kartikye/MySat/README.md

# SASSat
Singapore American School Satellite
