kartikye/MySat/Schematics/EPS/Flight Model/Charging Rate.xlsx

Time | Voltage
12:47:00 | 3.837
12:52:00 | 3.843
12:58:00 | 3.851
13:03:00 | 3.856
13:08:00 | 3.861
13:13:00 | 3.864
13:18:00 | 3.87
13:24:00 | 3.875
13:29:00 | 3.881
13:43:00 | 3.883
13:59:00 | 3.888
14:27:00 | 3.89
14:44:00 | 3.918
14:52:00 | 3.929
15:03:00 | 3.943
15:33:00 | 3.958
