kartikye/MySat/Costs.xlsx

Sheet: Overview
Simple Space Systems BOM
No. | Subsystem | Number of Parts | Cost
1 | Electronic Power System | 114 | $117.62
2 | Radio Board | 11 | $49.75
3 | On Board Computer | 25 | $52.65
4 | Structure | 55 | $435.14
5 | Labsat | 35 | $89.52
 |  | Total | $744.67
 |  | Sell Price | $4000.00
 |  | Profit | $3255.33
 |  | Markup | 437.1474898%

Sheet: LabSat
Structure BOM
No. | Type | Part | Value | Quantity | Manufacturer | Cost | Total
1 | Connector | FX8C-60P-SV |  | 4 | Hirose | $5.76 | $23.03
2 | Switch | TL3301 |  | 1 | E-Switch | $0.67 | $0.67
3 | Programmer | Arduino Uno |  | 1 | Arduino | $33.92 | $33.92
4 | Standoff | 2mm Standoff |  | 28 |  |  | $0.00
5 |  |  |  |  |  |  | $0.00
6 |  |  |  |  |  |  | $0.00
 | PCB |  |  | 1 | SeeedStudio | $31.90 | $31.90
 |  |  |  |  |  |  | $0.00
 |  |  |  |  |  |  | $0.00
 |  |  |  |  |  |  | $0.00
 |  |  |  |  |  |  | $0.00
 |  |  |  |  |  |  | $0.00
 |  |  |  |  |  |  | $0.00
 | Total: |  |  |  |  |  | $89.52

Sheet: Structure
Structure BOM
No. | Type | Part | Value | Quantity | Manufacturer | Cost | Total
1 | PCB | Side Panel |  | 4 | SeeedStudio | $2.71 | $10.84
2 | PCB | Top Panel |  | 1 | SeeedStudio | $2.71 | $2.71
3 | PCB | Bottom Panel |  | 1 | SeeedStudio | $4.10 | $4.10
4 | Solar Cells | Solar Cell |  | 48 | TriSolX | $5.43 | $260.64
5 | CNC | Corners |  | 1 | SeeedStudio | $146.43 | $146.43
6 | Switches | D2MQ-1L |  | 2 | Omron | $5.21 | $10.42
 | Total: |  |  |  |  |  | $435.14

Sheet: On Board Computer
On Board Computer BOM |  |  |  |  |  |  |  | Octopart Add-In is ready | j
No. | Type | Part | Value | Quantity | Manufacturer | Cost | Total |  | Datasheet
1 | Capacitor | 0805B104J500CT | 0.1uF | 4 |  | $0.004 | $0.02 |  | http://datasheet.octopart.com/0805B104J500CT-Walsin-Technologies-datasheet-48038160.pdf
2 | Capacitor | C0805C224K5RACTU | 0.22uF | 1 |  | $0.07 | $0.07 |  | http://datasheet.octopart.com/C0805C224K5RAC7800-Kemet-datasheet-62098571.pdf
3 | Capacitor | C0805C475K3PACTU | 4.7uF | 1 |  | $0.47 | $0.47 |  | http://datasheet.octopart.com/C0805C475K3PACTU-Kemet-datasheet-60243838.pdf
4 | Capacitor | 0805N220J500CT | 22pF | 2 |  | $0.03 | $0.06 |  | http://datasheet.octopart.com/0805N220J500CT-Walsin-Technologies-datasheet-48038160.pdf
5 | Tantalum Capacitor | TAJR106K006RNJ | 10uF | 1 |  | $0.44 | $0.44 |  | http://datasheet.octopart.com/TAJR106K006RNJ-AVX-datasheet-10925046.pdf
6 | Connector | FX8C-60S-SV |  | 1 | Hirose | $6.35 | $6.35 |  | http://datasheet.octopart.com/FX8C-60S-SV5%2891%29-Hirose-datasheet-8384353.pdf
7 | Connector | FX8C-60P-SV |  | 1 | Hirose | $5.76 | $5.76 |  | http://datasheet.octopart.com/FX8C-60P-SV6%2891%29-Hirose-datasheet-44103168.pdf
8 | Connector | SHR-02V-S-B |  | 1 |  | $0.02 | $0.02 |  | http://datasheet.octopart.com/SHR-02V-S-B-JST-datasheet-5322443.pdf
9 | Resistor | CR0805-JW-104ELF | 10k | 5 |  | $0.16 | $0.82 |  | http://datasheet.octopart.com/CR0805-JW-104ELF-Bourns-datasheet-49799764.pdf
10 | IC | ATMEGA328P-AU |  | 1 | Atmel | $5.73 | $5.73 |  | http://datasheet.octopart.com/ATMEGA328P-AU-Atmel-datasheet-14421303.pdf
11 | IC | DS1388Z-33+T&R |  | 1 |  | $4.95 | $4.95 |  | http://datasheet.octopart.com/DS1388Z-33%2BT%26R-Maxim-Integrated-datasheet-62054837.pdf
12 | IC | LSM9DS0 |  | 1 | ST Electronics | $14.99 | $14.99 |  | http://datasheet.octopart.com/LSM9DS0TR-STMicroelectronics-datasheet-16347594.pdf
13 | IC | LTC2990IMSPBF |  | 1 | Linear Technologies | $9.00 | $9.00 |  | http://datasheet.octopart.com/LTC2990IMS%23PBF-Linear-Technology-datasheet-10978018.pdf
14 | Inductor | CI160808-4N7D |  | 1 |  | $0.16 | $0.16 |  | http://datasheet.octopart.com/CI160808-4N7D-Bourns-datasheet-11480061.pdf
15 | Crystal | ABS25-32.768KHZ-6-T |  | 1 |  | $0.70 | $0.70 |  | http://datasheet.octopart.com/ABS25-32.768KHZ-6-T-Abracon-datasheet-11036012.pdf
16 | Crystal | ABM3-16.000MHZ-B2-T |  | 1 |  | $1.11 | $1.11 |  | http://datasheet.octopart.com/ABM3-16.000MHZ-B2-T-Abracon-datasheet-8488864.pdf
17 | PCB | PCB |  | 1 | SeeedStudio | $2.00 | $2.00
18 | Connector | 2998 |  | 1 | Keystone | ERROR: Server did not provide a response (The operation has timed out)
 | Total: |  |  |  |  |  | $52.65

Sheet: Electronic Power System
Electronic Power System BOM |  |  |  |  |  |  |  | Octopart Add-In is ready | h
No. | Type | Part | Value | Quantity | Manufacturer | Cost | Total |  |  | Datasheet
1 | Inductor | ELL6SH100M | 10uH | 3 | Panasonic | $1.83 | $5.49 |  |  | http://datasheet.octopart.com/ELL-6SH100M-Panasonic-datasheet-5327908.pdf
2 | Inductor | ELL3FU2R2N | 2.2uH | 1 | Panasonic | $2.10 | $2.10 |  |  | http://datasheet.octopart.com/ELL3FU2R2N-Panasonic-datasheet-10121769.pdf
3 | Capacitor | 0805B104J500CT | 0.1uF | 16 | Walsin Technologies | $0.04 | $0.69 |  |  | http://datasheet.octopart.com/0805B104J500CT-Walsin-Technologies-datasheet-48038160.pdf
4 | Capacitor | C2012X7R1E105K125AB | 1uF | 3 | Walsin Technologies | $0.23 | $0.68 |  |  | http://datasheet.octopart.com/C2012X7R1E105K-TDK-datasheet-10978788.pdf
5 | Capacitor | C0805C475K3PACTU | 4.7uF | 8 | Walsin Technologies | $0.47 | $3.75 |  |  | http://datasheet.octopart.com/C0805C475K3PACTU-Kemet-datasheet-60243838.pdf
6 | Capacitor | 0805F106Z100CT | 10uF | 8 | Walsin Technologies | $0.12 | $0.93 |  |  | http://datasheet.octopart.com/0805F106Z100CT-Walsin-Technologies-datasheet-48038160.pdf
7 | Resistor | ERJP06F7870V | 787 | 1 | Panasonic | $0.12 | $0.12 |  |  | http://datasheet.octopart.com/ERJ-P06F7870V-Panasonic-datasheet-13272697.pdf
8 | Resistor | CR0805-FX-4701ELF | 4.7k | 3 | Bourns | $0.16 | $0.49 |  |  | http://datasheet.octopart.com/CR0805-FX-4701ELF-Bourns-datasheet-49799764.pdf
9 | Resistor | CR0805-FX-1502ELF | 15k | 3 | Bourns | $0.16 | $0.49 |  |  | http://datasheet.octopart.com/CR0805-FX-1502ELF-Bourns-datasheet-49799764.pdf
10 | Resistor | ERJP06F2152V | 21.5k | 1 | Panasonic | $0.12 | $0.12 |  |  | http://datasheet.octopart.com/ERJP06F2152V-Panasonic-datasheet-5389633.pdf
11 | Resistor | ERJP06F3572V | 35.7k | 8 | Panasonic | $0.12 | $0.96 |  |  | http://datasheet.octopart.com/ERJ-P06F3572V-Panasonic-datasheet-13272697.pdf
12 | Resistor | CR0805-JW-104ELF | 100k | 8 | Bourns | $0.16 | $1.30 |  |  | http://datasheet.octopart.com/CR0805-JW-104ELF-Bourns-datasheet-49799764.pdf
13 | Resistor | ERJU06F4703V | 466k | 3 |  | $0.11 | $0.33 |  |  | http://datasheet.octopart.com/ERJU06F4703V-Panasonic-datasheet-11808117.pdf
14 | Resistor | ERJU06F4703V | 470k | 5 |  | $0.11 | $0.55 |  |  | http://datasheet.octopart.com/ERJU06F4703V-Panasonic-datasheet-11808117.pdf
15 | IC | BQ24210DQCT |  | 1 | Texas Instruments | $4.21 | $4.21 |  |  | https://octopart-clicks.com/click/track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
16 | IC | TPS2552DRVT |  | 6 | Texas Instruments | $2.86 | $17.18 |  |  | https://octopart-clicks.com/click/track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
17 | IC | TPS2553DRVT |  | 2 | Texas Instruments | $3.63 | $7.26 |  |  | https://octopart-clicks.com/click/track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
18 | Connector | FX8C-60P-SV |  | 1 | Hirose | $5.76 | $5.76 |  |  | http://datasheet.octopart.com/FX8C-60P-SV6%2891%29-Hirose-datasheet-44103168.pdf
19 | Connector | FX8C-60S-SV |  | 1 | Hirose | $6.35 | $6.35 |  |  | http://datasheet.octopart.com/FX8C-60S-SV5%2891%29-Hirose-datasheet-8384353.pdf
20 | Connector | SHR-02V-S-B |  | 10 |  | $0.19 | $1.87 |  |  | http://datasheet.octopart.com/SHR-02V-S-B-JST-datasheet-5322443.pdf
21 | Connector | SHR-03V-S-B |  | 10 |  | $0.08 | $0.85 |  |  | http://datasheet.octopart.com/SHR-03V-S-B-JST-datasheet-12489618.pdf
22 | IC | LTC3105EDDPBF |  | 3 | Linear Technologies | $9.41 | $28.23 |  |  | http://datasheet.octopart.com/LTC3105EDD%23PBF-Linear-Technology-datasheet-10546524.pdf
23 | IC | LTC4413EDDPBF |  | 5 | Linear Technologies | $3.85 | $19.25 |  |  | http://datasheet.octopart.com/LTC4413EDD%23PBF-Linear-Technology-datasheet-10701953.pdf
24 | IC | MCP130T-315I/TT |  | 1 |  | $0.36 | $0.36 |  |  | http://datasheet.octopart.com/MCP130T-315I/TT-Microchip-datasheet-345.pdf
25 | IC | PCA9534PW |  | 1 | Texas Instruments | $3.16 | $3.16 |  |  | https://octopart-clicks.com/click/track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
26 | IC | TPS63001DRCR |  | 1 | Texas Instruments | $3.13 | $3.13 |  |  | https://octopart-clicks.com/click/track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
27 | PCB | PCB |  | 1 | SeeedStudio | $2.00 | $2.00
 | Total: |  |  |  |  |  | $117.62

Sheet: Radio Board
Radio Board BOM |  |  |  |  |  |  |  | Octopart Add-In is ready | k
No. | Type | Part | Value | Quantity | Manufacturer | Cost | Total |  | Datasheet
1 | Polarized Capacitor | F980J476MSA | 47uF | 1 |  | $0.38 | $0.38 |  | ERROR: Datasheet url not found. Please try expanding your search
2 | Capacitor | 0805B104J500CT | 0.1uF | 1 |  | $0.004 | $0.004 |  | http://datasheet.octopart.com/0805B104J500CT-Walsin-Technologies-datasheet-48038160.pdf
3 | Balun | CX2156NL |  | 1 | Pulse | $2.73 | $2.73 |  | http://datasheet.octopart.com/CX2156NL-Pulse-datasheet-8613745.pdf
4 | IC | RF4463F30 |  | 2 | NiceRf | $11.86 | $23.72
5 | Connector | FX8C-60S-SV |  | 1 | Hirose | $6.35 | $6.35 |  | http://datasheet.octopart.com/FX8C-60S-SV5%2891%29-Hirose-datasheet-8384353.pdf
6 | Connector | FX8C-60P-SV |  | 1 | Hirose | $5.76 | $5.76 |  | http://datasheet.octopart.com/FX8C-60P-SV6%2891%29-Hirose-datasheet-44103168.pdf
7 | Connector | A-2JA |  | 2 | Amphenol RF | $1.31 | $2.62 |  | http://datasheet.octopart.com/A-2JA-Amphenol-RF-datasheet-38162442.pdf
8 | Wire | A-2PA-081-050B2 |  | 1 | Amphenol RF | $6.18 | $6.18 |  | http://datasheet.octopart.com/A-2PA-081-050B2-Amphenol-RF-datasheet-38084996.pdf
9 | PCB | PCB |  | 1 | SeeedStudio | $2.00 | $2.00
 | Total: |  |  |  |  |  | $49.75

Sheet: Stock
Parts Stock
No. | Type | Part | Value | Manufacturer | Stock | Source | Cost
1 | Balun | CX2156NL |  | Pulse | 2 | Link | $2.73 | $5.46
2 | Capacitor | 0805N220J500CT | 22pF | Walsin | 30 | Link | $0.04 | $1.32
3 | Capacitor | 0805B104J500CT | 0.1uF | Walsin | 46 | Link | $0.04 | $1.98
4 | Capacitor | C0805C224K5RACTU | 0.22uF | Kemmet | 5 | Link | $0.07 | $0.37
5 | Capacitor | C2012X7R1E105K125AB | 1uF | Kemmet | 115 | Link | $0.16 | $18.52
6 | Capacitor | C0805C475K3PACTU | 4.7uF | Kemmet | 45 | Link | $0.22 | $10.04
7 | Capacitor | 0805F106Z100CT | 10uF | Walsin | 66 | Link | $0.12 | $7.66
8 | Connector | FX8C-60S-SV |  | Hirose | 3 | Link | $5.52 | $16.57
9 | Connector | FX8C-60P-SV |  | Hirose | 3 | Link | $4.89 | $14.66
10 | Connector | SHR-02V-S-B |  | JST | 0 | Link | $0.19 | $0.00
11 | Connector | SHR-03V-S-B |  | JST | 0 | Link | $0.08 | $0.00
12 | Connector | A-2JA |  | Amphenol RF | 5 | Link | $1.31 | $6.55
13 | Crystal | ABS25-32.768KHZ-6-T |  | Abracon | 5 | Link | $0.58 | $2.89
14 | Crystal | ABM3-16.000MHZ-B2-T |  | Abracon | 7 | Link | $0.98 | $6.89
15 | IC | ATMEGA328P-AU |  | Atmel | 2 | Link | $5.28 | $10.55
16 | IC | DS1388Z-33+T&R |  | Maxim Integrated | 3 | Link | $4.49 | $13.47
17 | IC | LSM9DS0 |  | ST Electronics | 1 | Link | $12.27 | $12.27
18 | IC | LTC2990IMSPBF |  | Linear Technologies | 2 | Link | $8.66 | $17.31
19 | IC | BQ24210DQCT |  | Texas Instruments | 1 | Link | $3.69 | $3.69
20 | IC | TPS2552DRVT |  | Texas Instruments | 8 | Link | $2.68 | $21.43
21 | IC | TPS2553DRVT |  | Texas Instruments | 0 | Link | $2.73 | $0.00
22 | IC | LTC3105EDDPBF |  | Linear Technologies | 3 | Link | $9.41 | $28.23
23 | IC | LTC4413EDDPBF |  | Linear Technologies | 10 | Link | $3.80 | $38.00
24 | IC | MCP130T-315I/TT |  | Microchip | 2 | Link | $0.52 | $1.04
25 | IC | PCA9534PW |  | Texas Instruments | 10 | Link | $2.33 | $23.35
26 | IC | TPS63001DRCR |  | Texas Instruments | 9 | Link | $3.13 | $28.17
27 | IC | RF4463F30 |  | NiceRf | 1 | Link | $11.83 | $11.83
28 | Inductor | CI160808-4N7D |  | Bourns | 5 | Link | $0.08 | $0.38
29 | Resistor | ERJP06F7870V | 787 | Panasonic | 45 | Link | $0.10 | $4.59
30 | Resistor | CR0805-FX-4701ELF | 4.7k | Bourns | 36 | Link | $0.06 | $2.20
31 | Resistor | CR0805-JW-104ELF | 10k | Bourns | 253 | Link | $0.09 | $23.02
32 | Resistor | CR0805-FX-1502ELF | 15k | Bourns | 36 | Link | $0.11 | $4.03
33 | Resistor | ERJP06F2152V | 21.5k | Panasonic | 80 | Link | $0.10 | $8.16
34 | Resistor | ERJP06F3572V | 35.7k | Panasonic | 36 | Link | $0.10 | $3.67
35 | Resistor | CR0805-JW-104ELF | 100k | Bourns | 100 | Link | $0.09 | $9.10
36 | Resistor | ERJU06F4703V | 466k | Panasonic |  | Link | $0.09 | $0.00
37 | Resistor | ERJU06F4703V | 470k | Panasonic |  | Link | $0.09 | $0.00
38 | Switch | TL3301 |  | E-Switch | 2 | Link | $0.65 | $1.31
39 | Switch | D2MQ-1L |  | Omron | 4 | Link | $5.06 | $20.23
40 | Tantalum Capacitor | TAJR106K006RNJ | 10uF | AVX | 10 | Link | $11.86 | $118.60
41 | Tantalum Capacitor | F980J476MSA | 47uF | AVX | 4 | Link | $0.38 | $1.52
42 | Wire | A-2PA-081-050B2 |  | Amphenol RF | 3 | Link | $6.18 | $18.54
43 | Connector | 2998 |  | Keystone | 5 | Link | $7.19
44 | Inductor | ELL6SH100M | 10uH | Panasonic | 1 | Link | $1.42 | $1.42
45 | Inductor | ELL3FU2R2N | 2.2uH | Panasonic | 0 | Link | $2.03 | $0.00
46 |  |  | 487 |  | 48 | Link | ERROR: Server did not provide a response (The operation has timed out)
47 |  |  |  |  |  | Link | ERROR: Query did not provide a result. Please widen your search criteria.
48 |  |  |  |  |  | Link | ERROR: Query did not provide a result. Please widen your search criteria.
49 |  |  |  |  |  | Link | ERROR: Query did not provide a result. Please widen your search criteria.
50 |  |  |  |  |  | Link | ERROR: Query did not provide a result. Please widen your search criteria.
51 |  |  |  |  |  | Link | ERROR: Query did not provide a result. Please widen your search criteria.
52 |  |  |  |  |  | Link | ERROR: Query did not provide a result. Please widen your search criteria.
53 |  |  |  |  |  | Link | ERROR: Query did not provide a result. Please widen your search criteria.
54 |  |  |  |  |  | Link | ERROR: Query did not provide a result. Please widen your search criteria.
55 |  |  |  |  |  | Link | ERROR: Query did not provide a result. Please widen your search criteria.
56 |  |  |  |  |  | Link | ERROR: Query did not provide a result. Please widen your search criteria.
57 |  |  |  |  |  | Link | ERROR: Query did not provide a result. Please widen your search criteria.
58 |  |  |  |  |  | Link | ERROR: Query did not provide a result. Please widen your search criteria.
59 |  |  |  |  |  | Link | ERROR: Query did not provide a result. Please widen your search criteria.
60 |  |  |  |  |  | Link | ERROR: Query did not provide a result. Please widen your search criteria.
61 |  |  |  |  |  | Link | ERROR: Query did not provide a result. Please widen your search criteria.
62 |  |  |  |  |  | Link | ERROR: Query did not provide a result. Please widen your search criteria.
63 |  |  |  |  |  | Link | ERROR: Query did not provide a result. Please widen your search criteria.
64 |  |  |  |  |  | Link | ERROR: Query did not provide a result. Please widen your search criteria.
65 |  |  |  |  |  | Link | ERROR: Query did not provide a result. Please widen your search criteria.
66 |  |  |  |  |  | Link | ERROR: Query did not provide a result. Please widen your search criteria.
67 |  |  |  |  |  | Link | ERROR: Query did not provide a result. Please widen your search criteria.
68 |  |  |  |  |  | Link | ERROR: Query did not provide a result. Please widen your search criteria.
69 |  |  |  |  |  | Link | ERROR: Query did not provide a result. Please widen your search criteria.
70 |  |  |  |  |  | Link | ERROR: Query did not provide a result. Please widen your search criteria.
71 |  |  |  |  |  | Link | ERROR: Query did not provide a result. Please widen your search criteria.
72 |  |  |  |  |  | Link | ERROR: Query did not provide a result. Please widen your search criteria.
73 |  |  |  |  |  | Link | ERROR: Query did not provide a result. Please widen your search criteria.
74 |  |  |  |  |  | Link | ERROR: Query did not provide a result. Please widen your search criteria.
75 |  |  |  |  |  | Link | ERROR: Query did not provide a result. Please widen your search criteria.
76 |  |  |  |  |  | Link | ERROR: Query did not provide a result. Please widen your search criteria.
77 |  |  |  |  |  | Link | ERROR: Query did not provide a result. Please widen your search criteria.
78 |  |  |  |  |  | Link | ERROR: Query did not provide a result. Please widen your search criteria.
79 |  |  |  |  |  | Link | ERROR: Query did not provide a result. Please widen your search criteria.
80 |  |  |  |  |  | Link | ERROR: Query did not provide a result. Please widen your search criteria.
81 |  |  |  |  |  | Link | ERROR: Query did not provide a result. Please widen your search criteria.
82 |  |  |  |  |  | Link | ERROR: Query did not provide a result. Please widen your search criteria.
83 |  |  |  |  |  | Link | ERROR: Query did not provide a result. Please widen your search criteria.
84 |  |  |  |  |  | Link | ERROR: Query did not provide a result. Please widen your search criteria.
85 |  |  |  |  |  | Link | ERROR: Query did not provide a result. Please widen your search criteria.
86 |  |  |  |  |  | Link | ERROR: Query did not provide a result. Please widen your search criteria.
87 |  |  |  |  |  | Link | ERROR: Query did not provide a result. Please widen your search criteria.
88 |  |  |  |  |  | Link | ERROR: Query did not provide a result. Please widen your search criteria.
89 |  |  |  |  |  | Link | ERROR: Query did not provide a result. Please widen your search criteria.
90 |  |  |  |  |  | Link | ERROR: Query did not provide a result. Please widen your search criteria.
91 |  |  |  |  |  | Link | ERROR: Query did not provide a result. Please widen your search criteria.
92 |  |  |  |  |  | Link | ERROR: Query did not provide a result. Please widen your search criteria.
93 |  |  |  |  |  | Link | ERROR: Query did not provide a result. Please widen your search criteria.
94 |  |  |  |  |  | Link | ERROR: Query did not provide a result. Please widen your search criteria.
95 |  |  |  |  |  | Link | ERROR: Query did not provide a result. Please widen your search criteria.
96 |  |  |  |  |  | Link | ERROR: Query did not provide a result. Please widen your search criteria.
 | Total: |  |  |  | $383.00 |  |  | $519.02
 |  |  |  |  |  |  |  | .
