kartikye/MySat/Schematics/EPS/Flight Model/PQ60 EPS FV4.csv

Part | Value | Device | Package | Description
C1 | 10uF | C-USC0805 | C0805 | CAPACITOR, American symbol
C2 | 10uF | C-USC0805 | C0805 | CAPACITOR, American symbol
C3 | 10uF | C-USC0805 | C0805 | CAPACITOR, American symbol
C4 | 10uF | C-USC0805 | C0805 | CAPACITOR, American symbol
C5 | 10uF | C-USC0805 | C0805 | CAPACITOR, American symbol
C6 | 10uF | C-USC0805 | C0805 | CAPACITOR, American symbol
C7 | 4.7uF | C-USC0805 | C0805 | CAPACITOR, American symbol
C8 | 4.7uF | C-USC0805 | C0805 | CAPACITOR, American symbol
C9 | 10uF | C-USC0805 | C0805 | CAPACITOR, American symbol
C10 | 10uF | C-USC0805 | C0805 | CAPACITOR, American symbol
C11 | 4.7uF | C-USC0805 | C0805 | CAPACITOR, American symbol
C12 | 4.7uF | C-USC0805 | C0805 | CAPACITOR, American symbol
C13 | 4.7uF | C-USC0805 | C0805 | CAPACITOR, American symbol
C14 | 1uF | C-USC0805 | C0805 | CAPACITOR, American symbol
C15 | 1uF | C-USC0805 | C0805 | CAPACITOR, American symbol
C16 | 1uF | C-USC0805 | C0805 | CAPACITOR, American symbol
C17 | 0.1uF | C-USC0805 | C0805 | CAPACITOR, American symbol
C18 | .1uF | C-USC0805 | C0805 | CAPACITOR, American symbol
C19 | 0.1uF | C-USC0805 | C0805 | CAPACITOR, American symbol
C20 | 0.1uF | C-USC0805 | C0805 | CAPACITOR, American symbol
C21 | 4.7uF | C-USC0805 | C0805 | CAPACITOR, American symbol
C22 | 4.7uF | C-USC0805 | C0805 | CAPACITOR, American symbol
C23 | .1uF | C-USC0805 | C0805 | CAPACITOR, American symbol
C24 | 0.1uF | C-USC0805 | C0805 | CAPACITOR, American symbol
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
U10 | PCA9534PW | PCA9534PW | SOP65P640X110-16N | IC, IO PORT, I2C/SMBUS 8BIT, 16TSSOP
U11 | DRV | DRV | DRV
U12 | DRV | DRV | DRV
U13 | LTC4413EDDPBF | LTC4413EDDPBF | DFN300X300X80-11N | Dual 2.6A, 2.5V to 5.5V, Ideal Diodes
U14 | DRV | DRV | DRV
U15 | DRV | DRV | DRV
U16 | LTC4413EDDPBF | LTC4413EDDPBF | DFN300X300X80-11N | Dual 2.6A, 2.5V to 5.5V, Ideal Diodes
U17 | DRV | DRV | DRV
U18 | DRV | DRV | DRV
U19 | LTC4413EDDPBF | LTC4413EDDPBF | DFN300X300X80-11N | Dual 2.6A, 2.5V to 5.5V, Ideal Diodes
