kartikye/MySat/Schematics/Solar Panel/Full Side Panel V4 - Notched.dxf

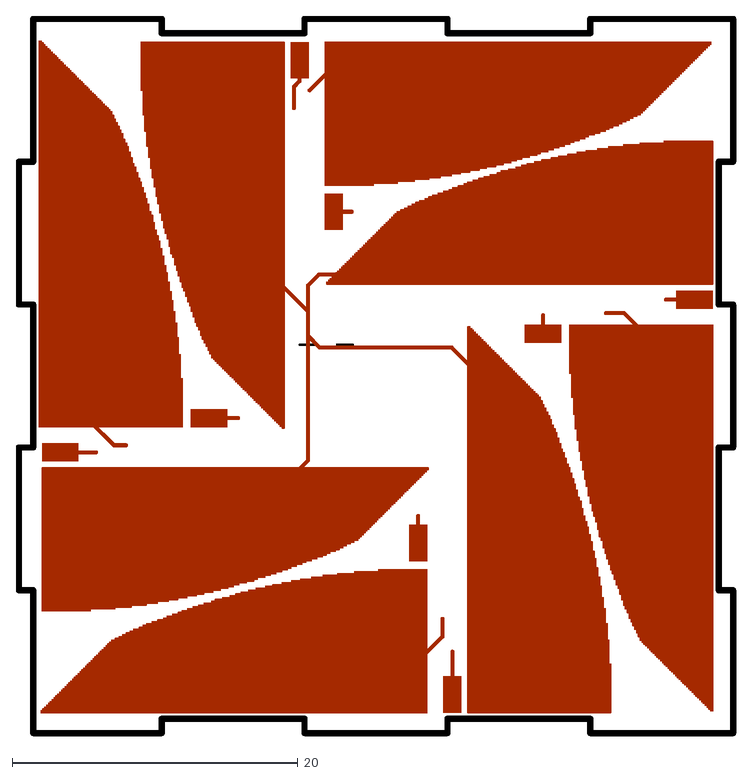
[picture p1: CAD file, 2015-08-25]
Schematics/Solar Panel/Full Side Panel V4 - Notched.dxf
50.4 x 50.4
