kartikye/MySat/Schematics/Solar Panel/All Panels V4 - Notched.dxf

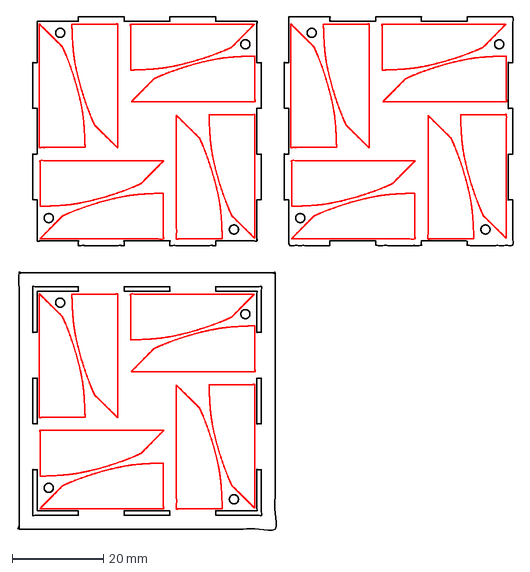
[picture p2: CAD file, 2015-08-25]
Schematics/Solar Panel/All Panels V4 - Notched.dxf
108.7 x 112.7 mm
