kartikye/MySat/Structure/EPS/Parts/FX8C-60P-SV.stp

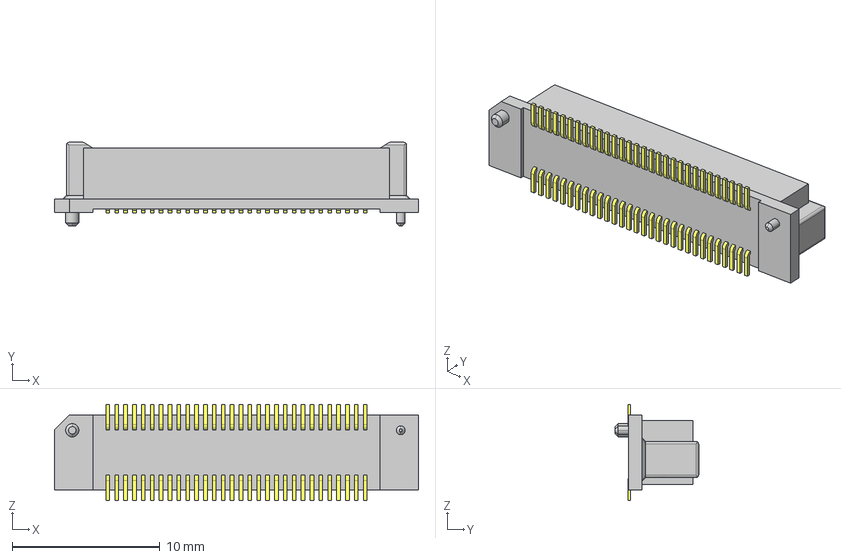
[picture p3: CAD file, 2015-12-20]
Structure/EPS/Parts/FX8C-60P-SV.stp
24.6 x 5.65 x 6.50 mm
