kartikye/MySat/Structure/V5/D2MQ_1.step

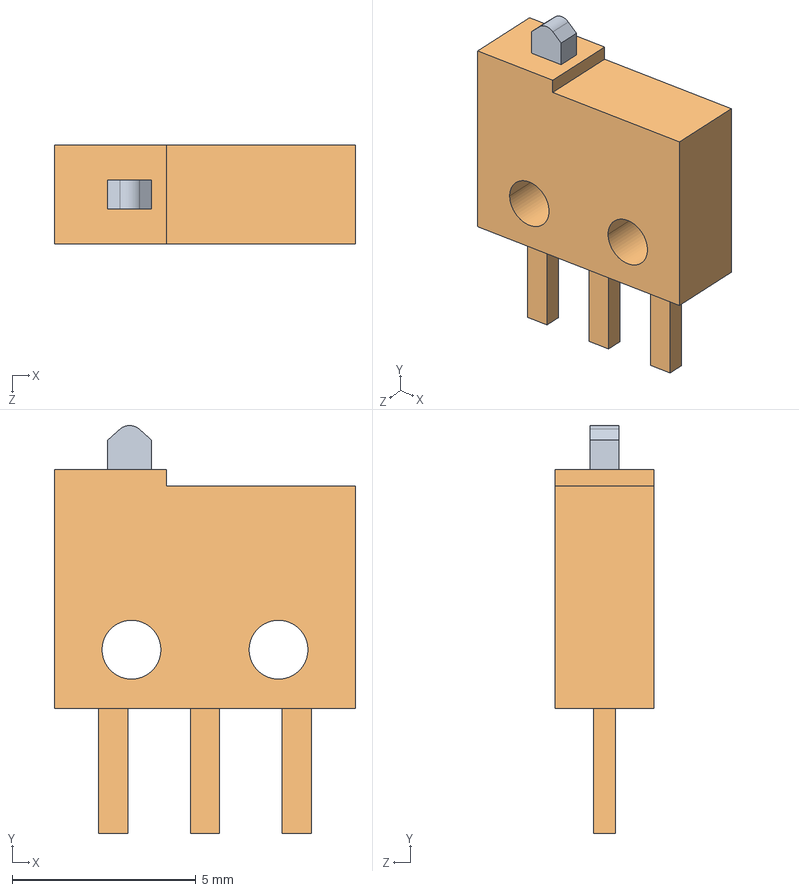
[picture p4: CAD file, 2015-12-20]
Structure/V5/D2MQ_1.step
8.20 x 11.1 x 2.70 mm
D2MQ_1_ACTUATOR
D2MQ_1_BASE
