kartikye/MySat/Schematics/Solar Panel/Top Panel Outline.dxf

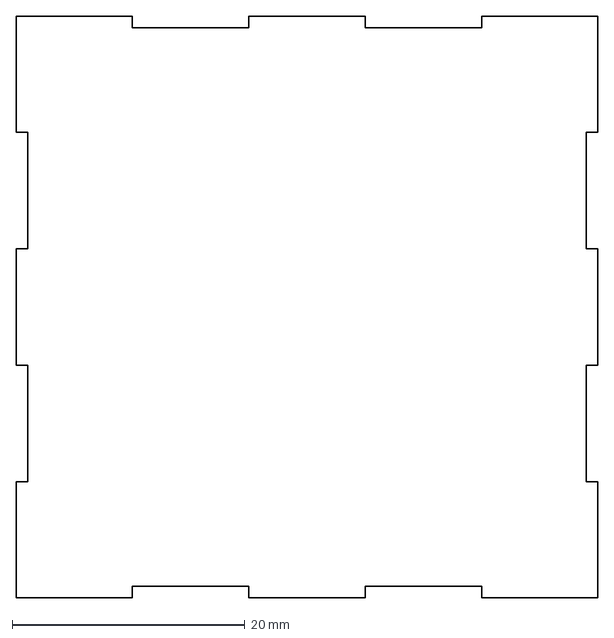
[picture p5: CAD file, 2015-08-25]
Schematics/Solar Panel/Top Panel Outline.dxf
50.0 x 50.0 mm
