kartikye/MySat/Structure/EPS/Parts/FX8C-60S-SV.stp

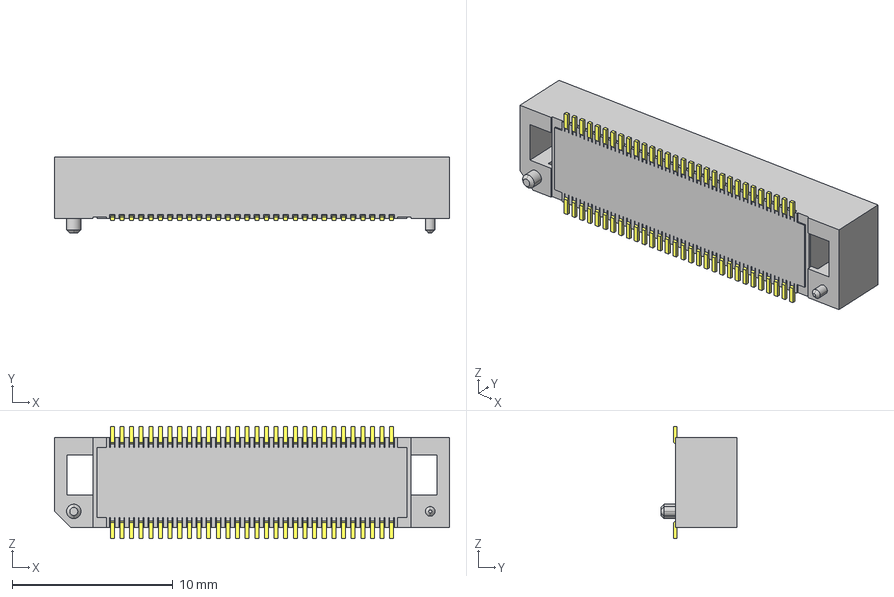
[picture p6: CAD file, 2015-12-20]
Structure/EPS/Parts/FX8C-60S-SV.stp
24.6 x 4.75 x 7.00 mm
