kartikye/MySat/Structure/V5/Corner2.stl

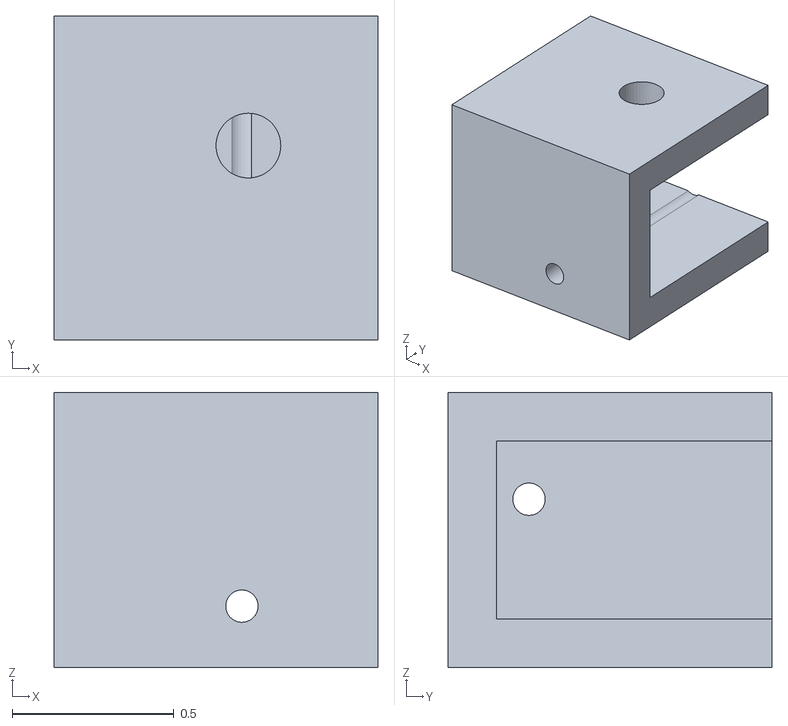
[picture p7: CAD file, 2015-09-08]
Structure/V5/Corner2.stl
1.00 x 1.00 x 0.85
