kartikye/MySat/Schematics/Solar Panel/Side Panel Outline.dxf

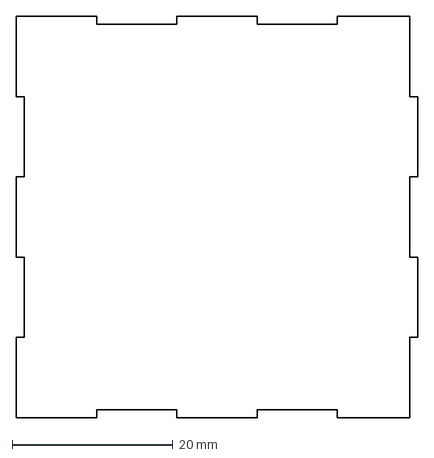
[picture p8: CAD file, 2015-08-25]
Schematics/Solar Panel/Side Panel Outline.dxf
50.0 x 50.0 mm
