kartikye/MySat/Structure/EPS/Parts/0805_cap_T1.25.stp

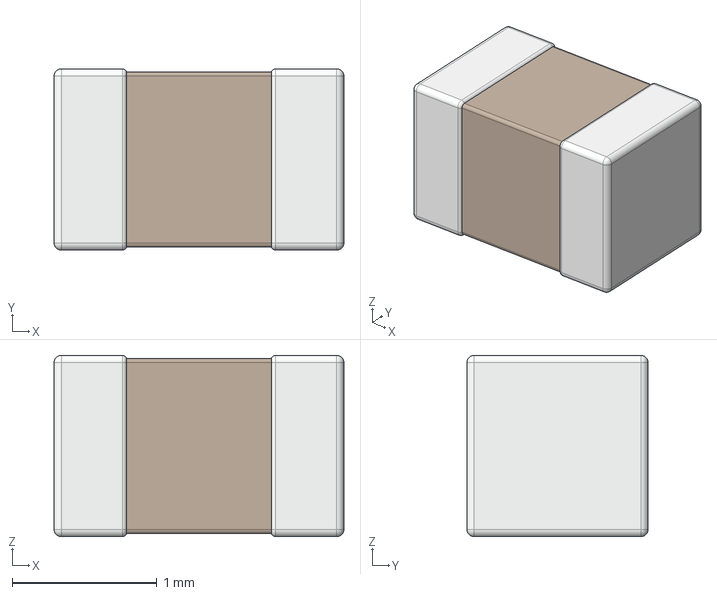
[picture p9: CAD file, 2015-12-20]
Structure/EPS/Parts/0805_cap_T1.25.stp
2.00 x 1.25 x 1.25 mm
