kartikye/MySat/Structure/V5/Bottom Panel V5 - Notched.dxf

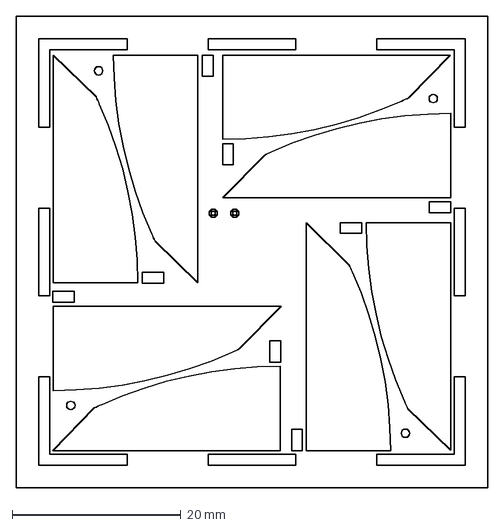
[picture p10: CAD file, 2015-08-25]
Structure/V5/Bottom Panel V5 - Notched.dxf
56.0 x 56.0 mm
