kartikye/MySat/Structure/EPS/Parts/0805_cap_T0.85.stp

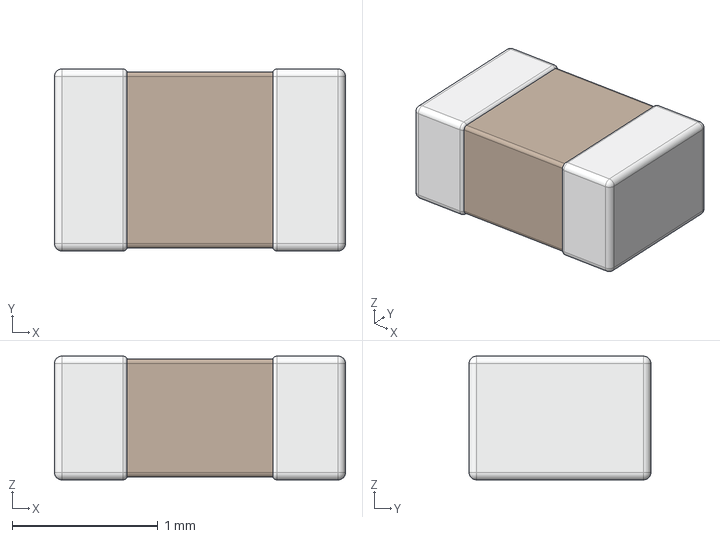
[picture p11: CAD file, 2015-12-20]
Structure/EPS/Parts/0805_cap_T0.85.stp
2.00 x 1.25 x 0.85 mm
