kartikye/MySat/Structure/V5/Bottom Panel.stl

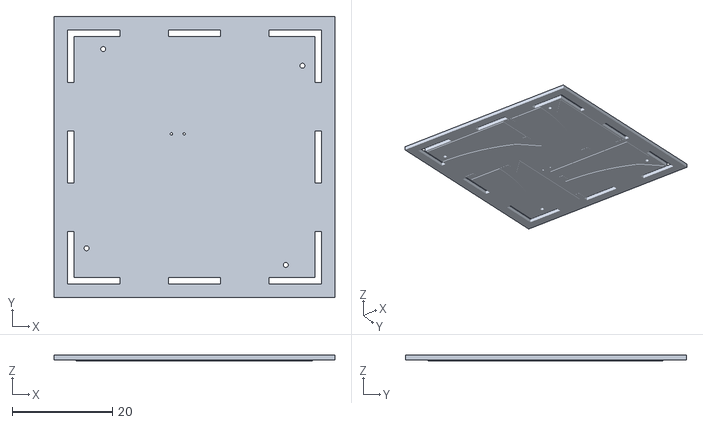
[picture p12: CAD file, 2015-08-25]
Structure/V5/Bottom Panel.stl
56.0 x 56.0 x 1.16
