kartikye/MySat/Schematics/Solar Panel/All Panels V4 - Notched 2mm .dxf

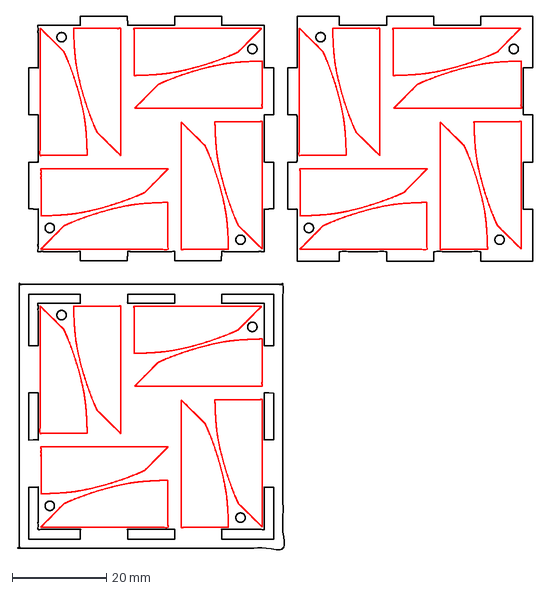
[picture p13: CAD file, 2015-08-25]
Schematics/Solar Panel/All Panels V4 - Notched 2mm .dxf
109.6 x 113.6 mm
