kartikye/MySat/Structure/EPS/Parts/RES0805.stp

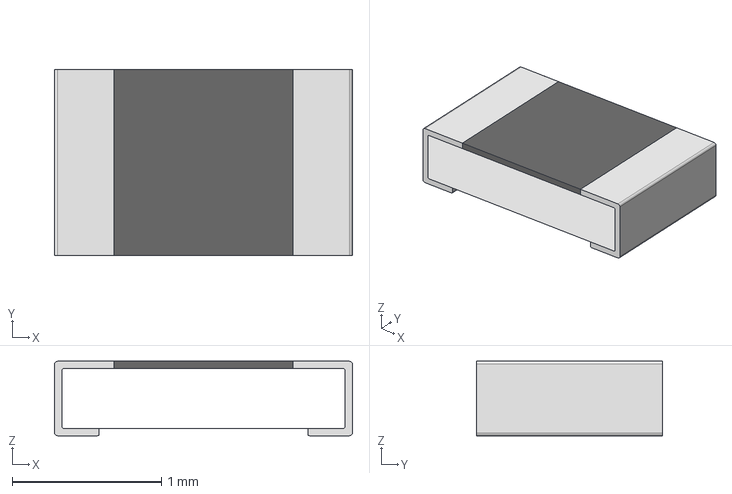
[picture p14: CAD file, 2015-12-20]
Structure/EPS/Parts/RES0805.stp
2.00 x 1.25 x 0.5 mm
