kartikye/MySat/Structure/V5/Bottom Panel No Panels.stl

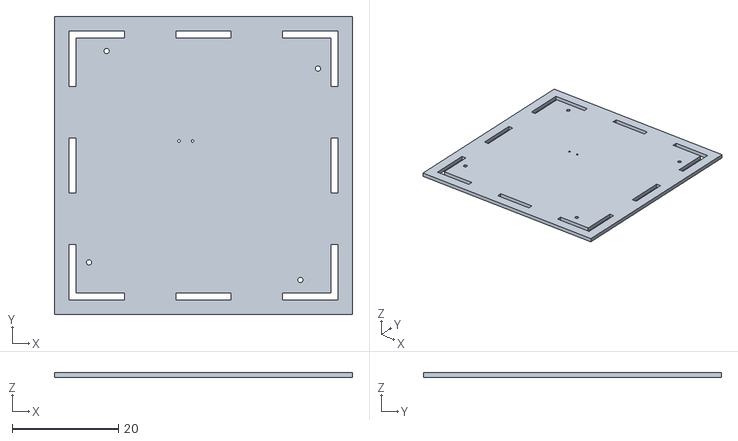
[picture p15: CAD file, 2015-08-25]
Structure/V5/Bottom Panel No Panels.stl
56.0 x 56.0 x 1.00
