kartikye/MySat/Structure/EPS/Parts/SM02B-SRSS-TB.STEP

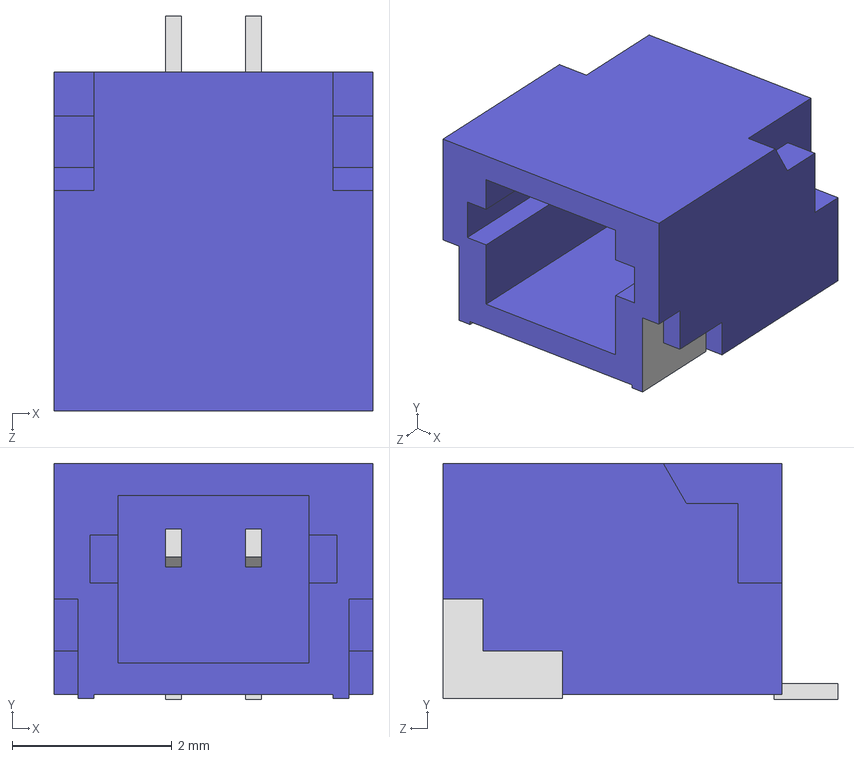
[picture p16: CAD file, 2015-12-20]
Structure/EPS/Parts/SM02B-SRSS-TB.STEP
4.00 x 2.96 x 4.95 mm
