kartikye/MySat/Structure/EPS/Parts/SM03B-SRSS-TB.STEP

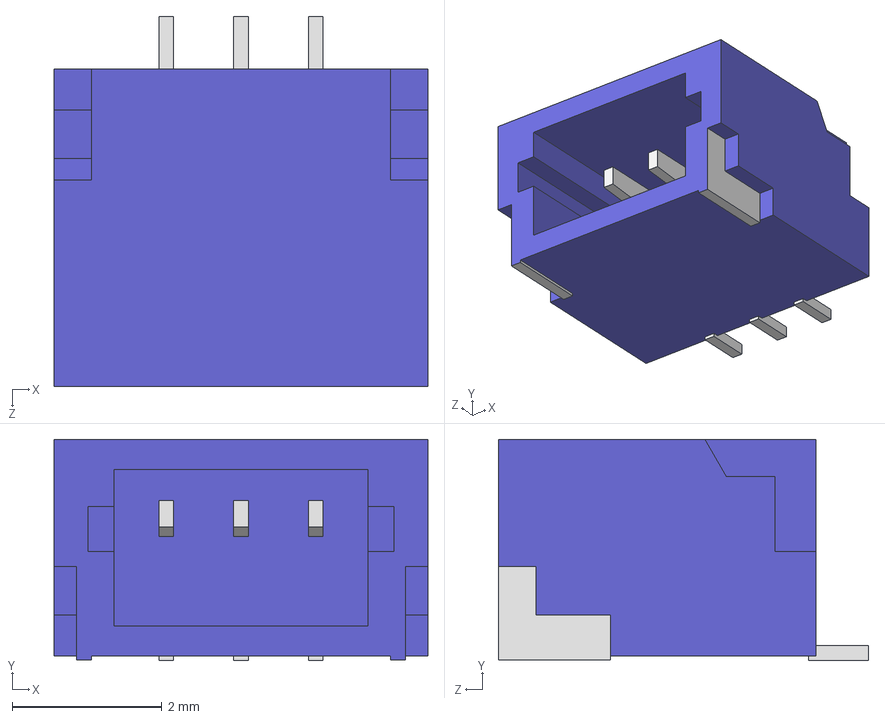
[picture p17: CAD file, 2015-12-20]
Structure/EPS/Parts/SM03B-SRSS-TB.STEP
5.00 x 2.96 x 4.95 mm
