kartikye/MySat/Structure/EPS/Parts/Capacitor_Package_0805_SMD.STEP

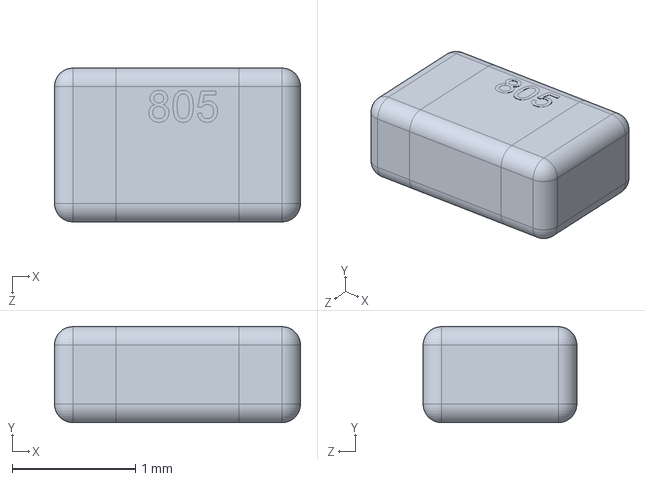
[picture p18: CAD file, 2015-12-20]
Structure/EPS/Parts/Capacitor_Package_0805_SMD.STEP
2.00 x 0.782 x 1.25 mm
