kartikye/MySat/(list of files, cad)

Other CAD files:
Structure/Antenna.ipt
Structure/Corner.ipt
Structure/EPS/OldVersions/PQ60 EPS FV4.brd.0001.iam
Structure/EPS/PQ60 EPS FV4.brd.iam
Structure/EPS/Parts/C0805, 10UF_1.ipt
Structure/EPS/Parts/C0805, 1UF_16.ipt
Structure/EPS/Parts/C0805, 4_7UF_8.ipt
Structure/EPS/Parts/C0805, _1UF_21.ipt
Structure/EPS/Parts/DFN300X300X80-11N, LTC3105EDDPBF_102.ipt
Structure/EPS/Parts/DFN300X300X80-11N, LTC4413EDDPBF_106.ipt
Structure/EPS/Parts/DRV, DRV_111.ipt
Structure/EPS/Parts/FX8C-060P-SV_92_, FX8C-060P-SV_92__90.ipt
Structure/EPS/Parts/FX8C-060S-SV_92_, FX8C-060S-SV_92__88.ipt
Structure/EPS/Parts/IND_ELL3FU, 2_2UH_44.ipt
Structure/EPS/Parts/IND_ELL6XH, 10UH_40.ipt
Structure/EPS/Parts/JST-SH-02, JST-SH-02_92.ipt
Structure/EPS/Parts/JST-SH-03, JST-SH-03_100.ipt
Structure/EPS/Parts/OldVersions/DFN300X300X80-11N, LTC3105EDDPBF_102.0002.ipt
Structure/EPS/Parts/OldVersions/DFN300X300X80-11N, LTC4413EDDPBF_106.0002.ipt
Structure/EPS/Parts/OldVersions/DRV, DRV_111.0002.ipt
Structure/EPS/Parts/OldVersions/IND_ELL3FU, 2_2UH_44.0002.ipt
Structure/EPS/Parts/OldVersions/SON50P200X300X80-11N, BQ24210DQCT_114.0002.ipt
Structure/EPS/Parts/OldVersions/SON50P300X300X100-11N, TPS63001DRCR_109.0002.ipt
Structure/EPS/Parts/OldVersions/SOP65P640X110-16N, PCA9534PW_116.0002.ipt
Structure/EPS/Parts/OldVersions/SOT95P237X112-3N, MCP130T-315I_TT_86.0002.ipt
Structure/EPS/Parts/PQ60 EPS FV4.brd_Outline.ipt
Structure/EPS/Parts/R0805, 100K_49.ipt
Structure/EPS/Parts/R0805, 15K_57.ipt
Structure/EPS/Parts/R0805, 21_5K_71.ipt
Structure/EPS/Parts/R0805, 35_7K_51.ipt
Structure/EPS/Parts/R0805, 466K_65.ipt
Structure/EPS/Parts/R0805, 470K_46.ipt
Structure/EPS/Parts/R0805, 4_7K_59.ipt
Structure/EPS/Parts/R0805, 787_69.ipt
Structure/EPS/Parts/SON50P200X300X80-11N, BQ24210DQCT_114.ipt
Structure/EPS/Parts/SON50P300X300X100-11N, TPS63001DRCR_109.ipt
Structure/EPS/Parts/SOP65P640X110-16N, PCA9534PW_116.ipt
Structure/EPS/Parts/SOT95P237X112-3N, MCP130T-315I_TT_86.ipt
Structure/Empty Inner PCB.ipt
Structure/Imported Components/0805_cap_T0.85/0805_cap_T0.85.ipt
Structure/Imported Components/0805_cap_T1.25/0805_cap_T1.25.ipt
Structure/Imported Components/7193K200/7193K200.ipt
Structure/Imported Components/D2MQ_1/D2MQ_1.iam
Structure/Imported Components/D2MQ_1/D2MQ_1_ACTUATOR.ipt
Structure/Imported Components/D2MQ_1/D2MQ_1_BASE.ipt
Structure/Imported Components/FX8C-60P-SV/FX8C-60P-SV.iam
Structure/Imported Components/FX8C-60P-SV/FX8C-60P-SV.ipt
Structure/Imported Components/FX8C-60P-SV1/FX8C-60P-SV1.iam
Structure/Imported Components/FX8C-60P-SV1/FX8C-60P-SV1.ipt
Structure/Imported Components/FX8C-60S-SV/FX8C-60S-SV.iam
Structure/Imported Components/FX8C-60S-SV/FX8C-60S-SV.ipt
Structure/Imported Components/PQ60 EPS FV4/1362560816.iam
Structure/Imported Components/PQ60 EPS FV4/1362560944.iam
Structure/Imported Components/PQ60 EPS FV4/1362561584.iam
Structure/Imported Components/PQ60 EPS FV4/1362562096.iam
Structure/Imported Components/PQ60 EPS FV4/1362563888.iam
Structure/Imported Components/PQ60 EPS FV4/1362564016.iam
Structure/Imported Components/PQ60 EPS FV4/1362564144.iam
Structure/Imported Components/PQ60 EPS FV4/1362564272.iam
Structure/Imported Components/PQ60 EPS FV4/1362564528.iam
Structure/Imported Components/PQ60 EPS FV4/1362564656.iam
Structure/Imported Components/PQ60 EPS FV4/1362564912.iam
Structure/Imported Components/PQ60 EPS FV4/1362565040.iam
Structure/Imported Components/PQ60 EPS FV4/1362565296.iam
Structure/Imported Components/PQ60 EPS FV4/1362565424.iam
Structure/Imported Components/PQ60 EPS FV4/1362565552.iam
Structure/Imported Components/PQ60 EPS FV4/1362565808.iam
Structure/Imported Components/PQ60 EPS FV4/1362565936.iam
Structure/Imported Components/PQ60 EPS FV4/1362566064.iam
Structure/Imported Components/PQ60 EPS FV4/1362566192.iam
Structure/Imported Components/PQ60 EPS FV4/1362566448.iam
Structure/Imported Components/PQ60 EPS FV4/1362566704.iam
Structure/Imported Components/PQ60 EPS FV4/1362566832.iam
Structure/Imported Components/PQ60 EPS FV4/1362567088.iam
Structure/Imported Components/PQ60 EPS FV4/1362567216.iam
Structure/Imported Components/PQ60 EPS FV4/1362567344.iam
Structure/Imported Components/PQ60 EPS FV4/1362567600.iam
Structure/Imported Components/PQ60 EPS FV4/1362567856.iam
Structure/Imported Components/PQ60 EPS FV4/1362567984.iam
Structure/Imported Components/PQ60 EPS FV4/1362568240.iam
Structure/Imported Components/PQ60 EPS FV4/1362568496.iam
Structure/Imported Components/PQ60 EPS FV4/1362568752.iam
Structure/Imported Components/PQ60 EPS FV4/1362568880.iam
Structure/Imported Components/PQ60 EPS FV4/1362569264.iam
Structure/Imported Components/PQ60 EPS FV4/1362569392.iam
Structure/Imported Components/PQ60 EPS FV4/1362569520.iam
Structure/Imported Components/PQ60 EPS FV4/1362569648.iam
Structure/Imported Components/PQ60 EPS FV4/1362569776.iam
Structure/Imported Components/PQ60 EPS FV4/1362569904.iam
Structure/Imported Components/PQ60 EPS FV4/1362570032.iam
Structure/Imported Components/PQ60 EPS FV4/1362570160.iam
Structure/Imported Components/PQ60 EPS FV4/1362570288.iam
Structure/Imported Components/PQ60 EPS FV4/1362570416.iam
Structure/Imported Components/PQ60 EPS FV4/1362570544.iam
Structure/Imported Components/PQ60 EPS FV4/1362570672.iam
Structure/Imported Components/PQ60 EPS FV4/1362570800.iam
Structure/Imported Components/PQ60 EPS FV4/1362570928.iam
Structure/Imported Components/PQ60 EPS FV4/1362571184.iam
Structure/Imported Components/PQ60 EPS FV4/1362571312.iam
Structure/Imported Components/PQ60 EPS FV4/1362571440.iam
Structure/Imported Components/PQ60 EPS FV4/1362571696.iam
Structure/Imported Components/PQ60 EPS FV4/1362571952.iam
Structure/Imported Components/PQ60 EPS FV4/Board.ipt
Structure/Imported Components/PQ60 EPS FV4/C1.iam
Structure/Imported Components/PQ60 EPS FV4/C10.iam
Structure/Imported Components/PQ60 EPS FV4/C11.iam
Structure/Imported Components/PQ60 EPS FV4/C12.iam
Structure/Imported Components/PQ60 EPS FV4/C13.iam
Structure/Imported Components/PQ60 EPS FV4/C14.iam
Structure/Imported Components/PQ60 EPS FV4/C15.iam
Structure/Imported Components/PQ60 EPS FV4/C16.iam
Structure/Imported Components/PQ60 EPS FV4/C17.iam
Structure/Imported Components/PQ60 EPS FV4/C18.iam
Structure/Imported Components/PQ60 EPS FV4/C19.iam
Structure/Imported Components/PQ60 EPS FV4/C2.iam
Structure/Imported Components/PQ60 EPS FV4/C20.iam
Structure/Imported Components/PQ60 EPS FV4/C21.iam
Structure/Imported Components/PQ60 EPS FV4/C22.iam
Structure/Imported Components/PQ60 EPS FV4/C23.iam
Structure/Imported Components/PQ60 EPS FV4/C24.iam
Structure/Imported Components/PQ60 EPS FV4/C25.iam
Structure/Imported Components/PQ60 EPS FV4/C26.iam
Structure/Imported Components/PQ60 EPS FV4/C27.iam
Structure/Imported Components/PQ60 EPS FV4/C28.iam
Structure/Imported Components/PQ60 EPS FV4/C29.iam
Structure/Imported Components/PQ60 EPS FV4/C3.iam
Structure/Imported Components/PQ60 EPS FV4/C30.iam
Structure/Imported Components/PQ60 EPS FV4/C31.iam
Structure/Imported Components/PQ60 EPS FV4/C32.iam
Structure/Imported Components/PQ60 EPS FV4/C33.iam
Structure/Imported Components/PQ60 EPS FV4/C34.iam
Structure/Imported Components/PQ60 EPS FV4/C35.iam
Structure/Imported Components/PQ60 EPS FV4/C4.iam
Structure/Imported Components/PQ60 EPS FV4/C5.iam
Structure/Imported Components/PQ60 EPS FV4/C6.iam
Structure/Imported Components/PQ60 EPS FV4/C7.iam
Structure/Imported Components/PQ60 EPS FV4/C8.iam
Structure/Imported Components/PQ60 EPS FV4/C9.iam
Structure/Imported Components/PQ60 EPS FV4/Extruded.ipt
Structure/Imported Components/PQ60 EPS FV4/Extruded_1.ipt
Structure/Imported Components/PQ60 EPS FV4/Extruded_10.ipt
Structure/Imported Components/PQ60 EPS FV4/Extruded_11.ipt
Structure/Imported Components/PQ60 EPS FV4/Extruded_12.ipt
Structure/Imported Components/PQ60 EPS FV4/Extruded_13.ipt
Structure/Imported Components/PQ60 EPS FV4/Extruded_14.ipt
Structure/Imported Components/PQ60 EPS FV4/Extruded_15.ipt
Structure/Imported Components/PQ60 EPS FV4/Extruded_16.ipt
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
