kartikye/MySat/Schematics/EPS/Flight Model/PQ60 EPS FV2.pdf

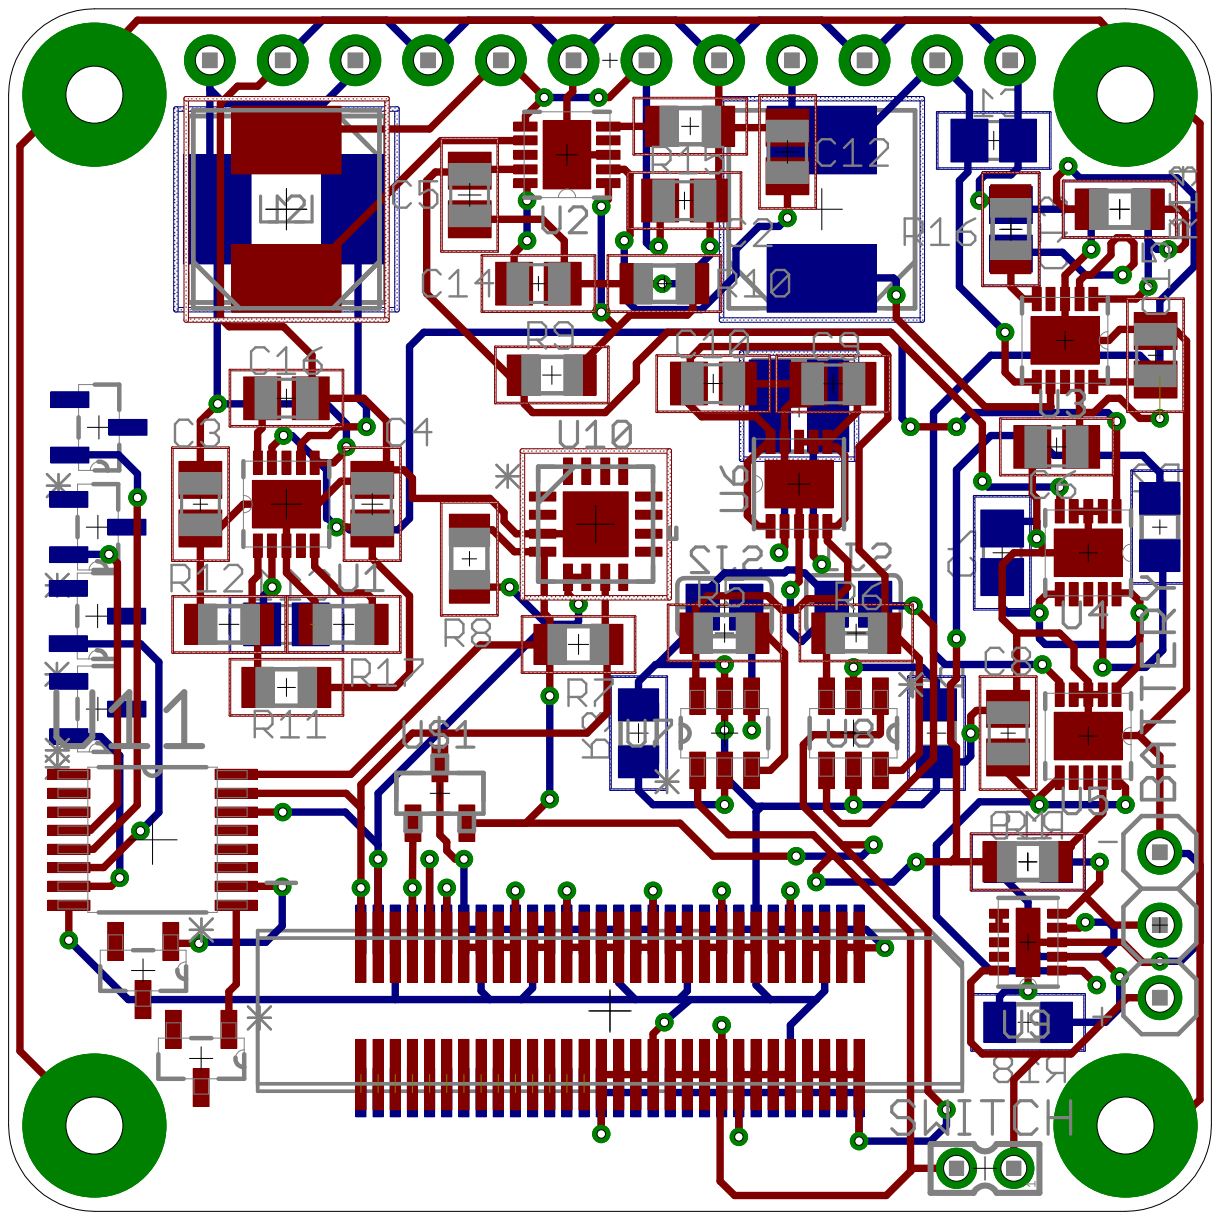
[picture p19: page 1]
