kartikye/MySat/Schematics/EPS/Flight Model/PQ60 EPS FV4.brd

## EAGLE design Schematics/EPS/Flight Model/PQ60 EPS FV4.brd (2016-03-22)

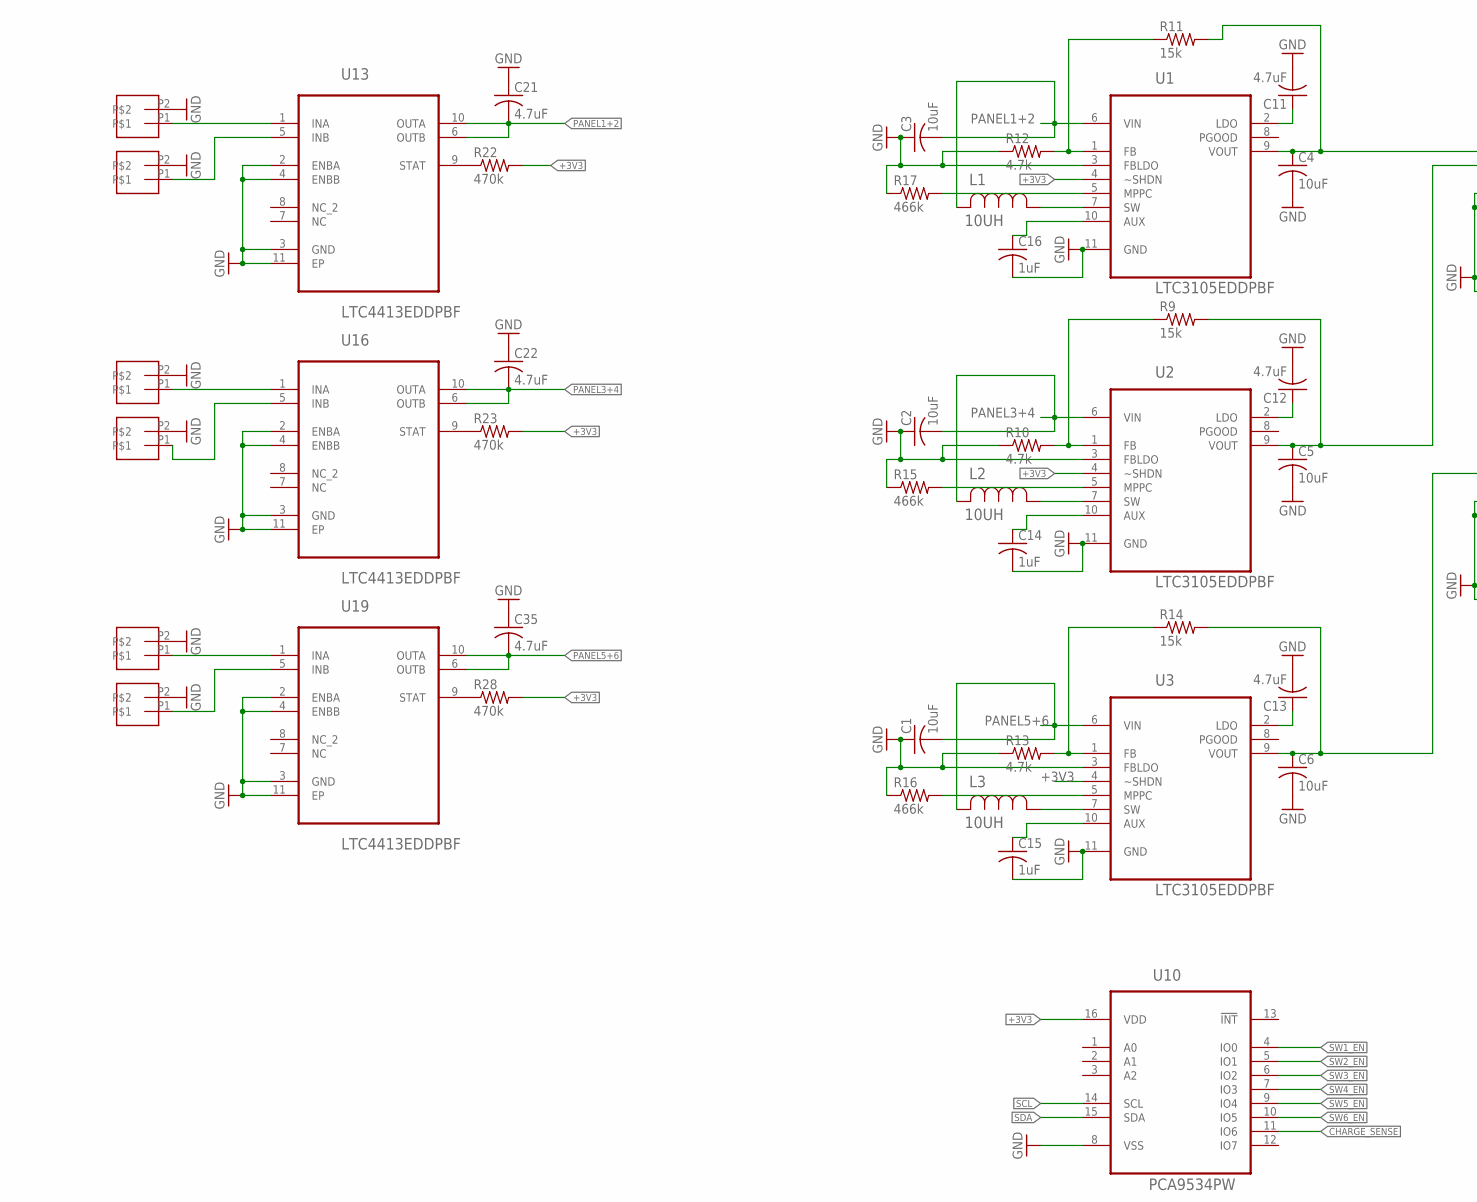
[picture p20: schematic PQ60 EPS FV4.sch, part in row 1, column 1]

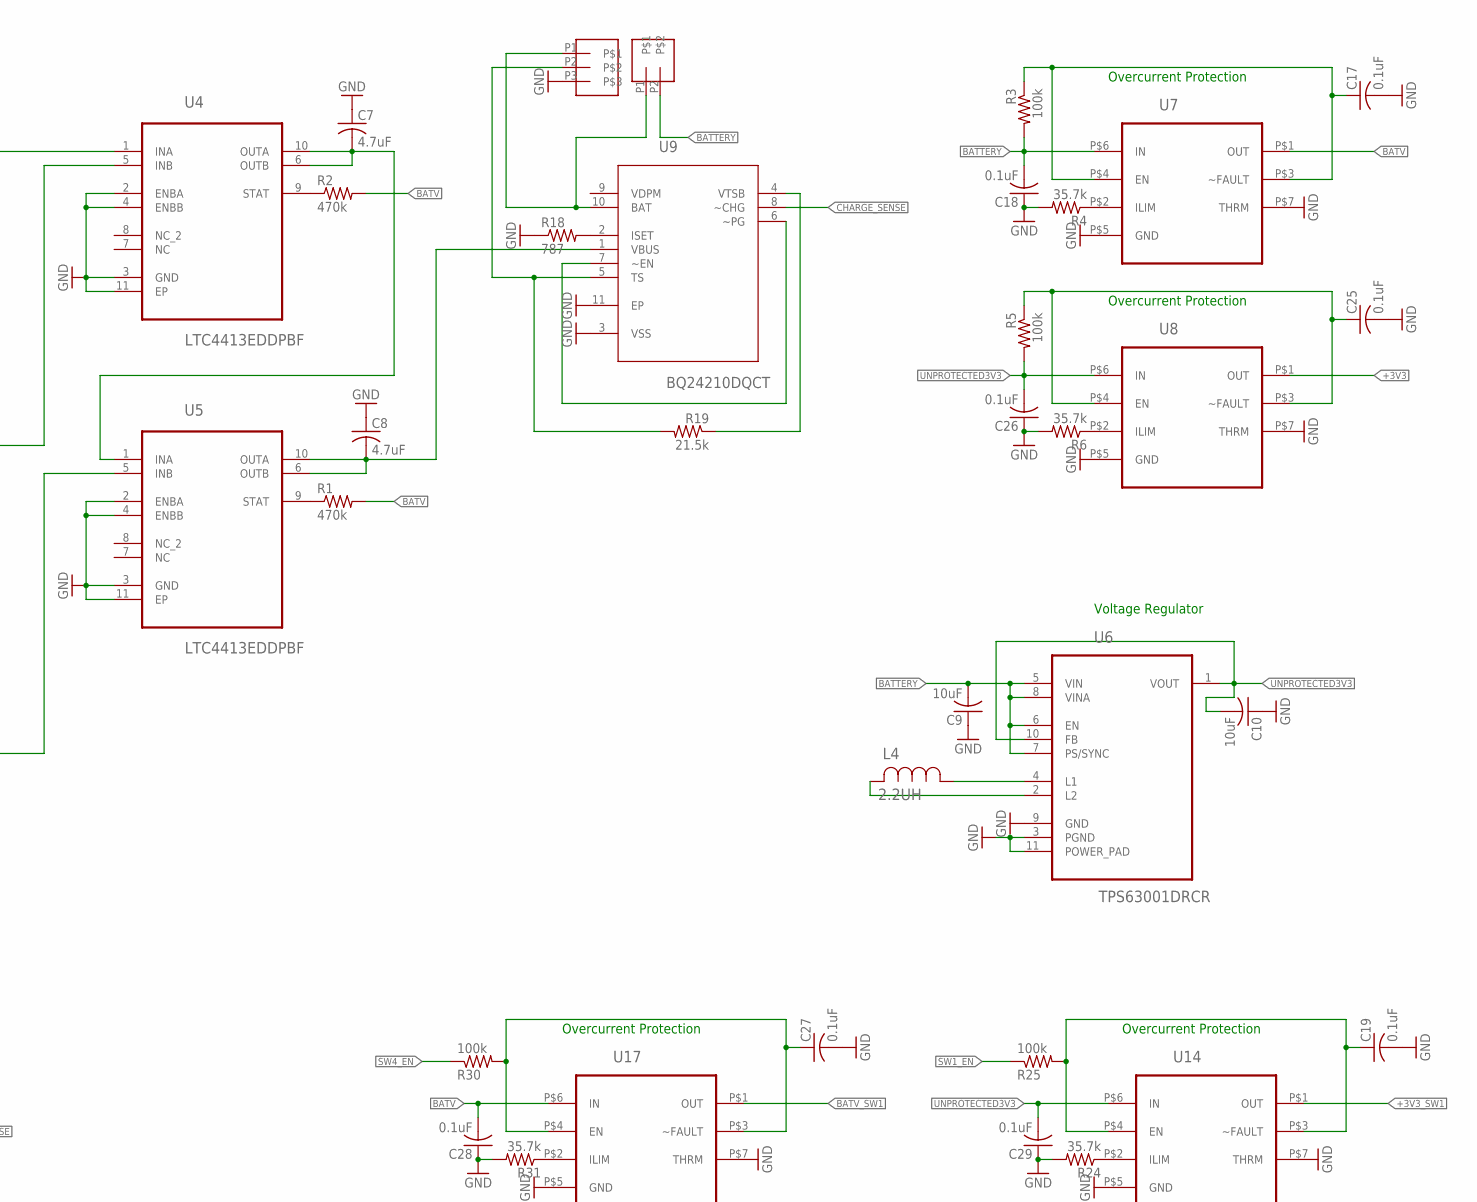
[picture p21: schematic PQ60 EPS FV4.sch, part in row 1, column 2]

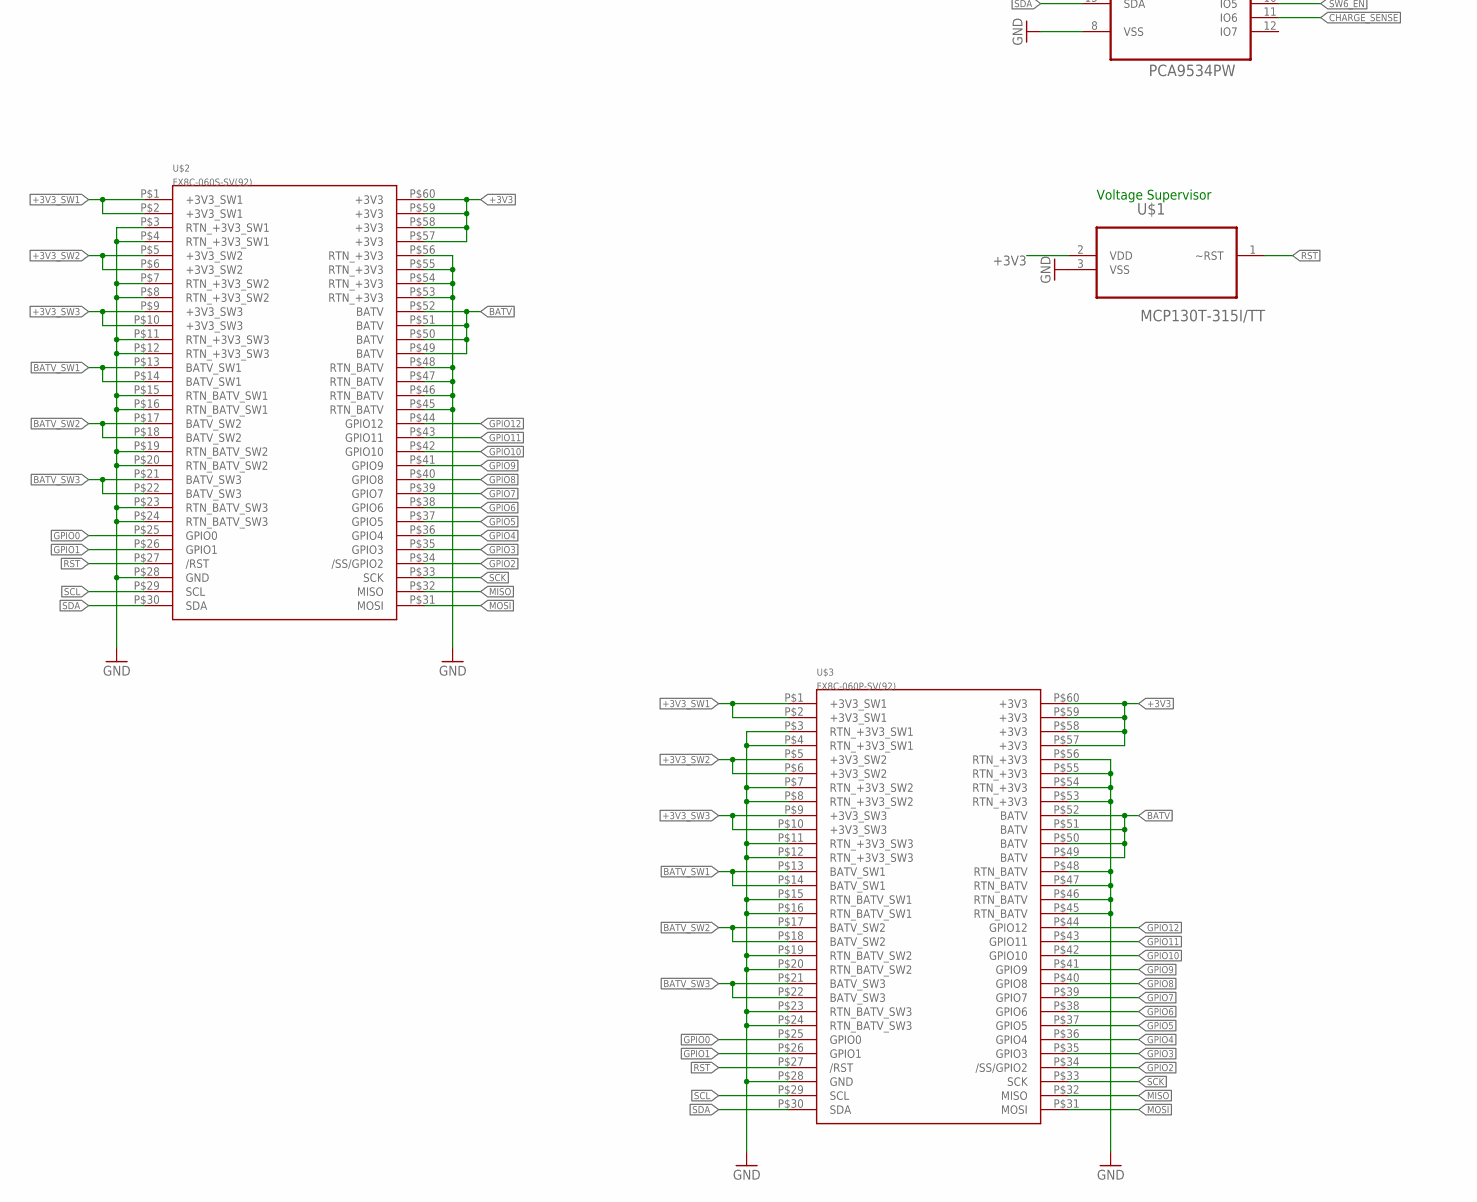
[picture p22: schematic PQ60 EPS FV4.sch, part in row 2, column 1]

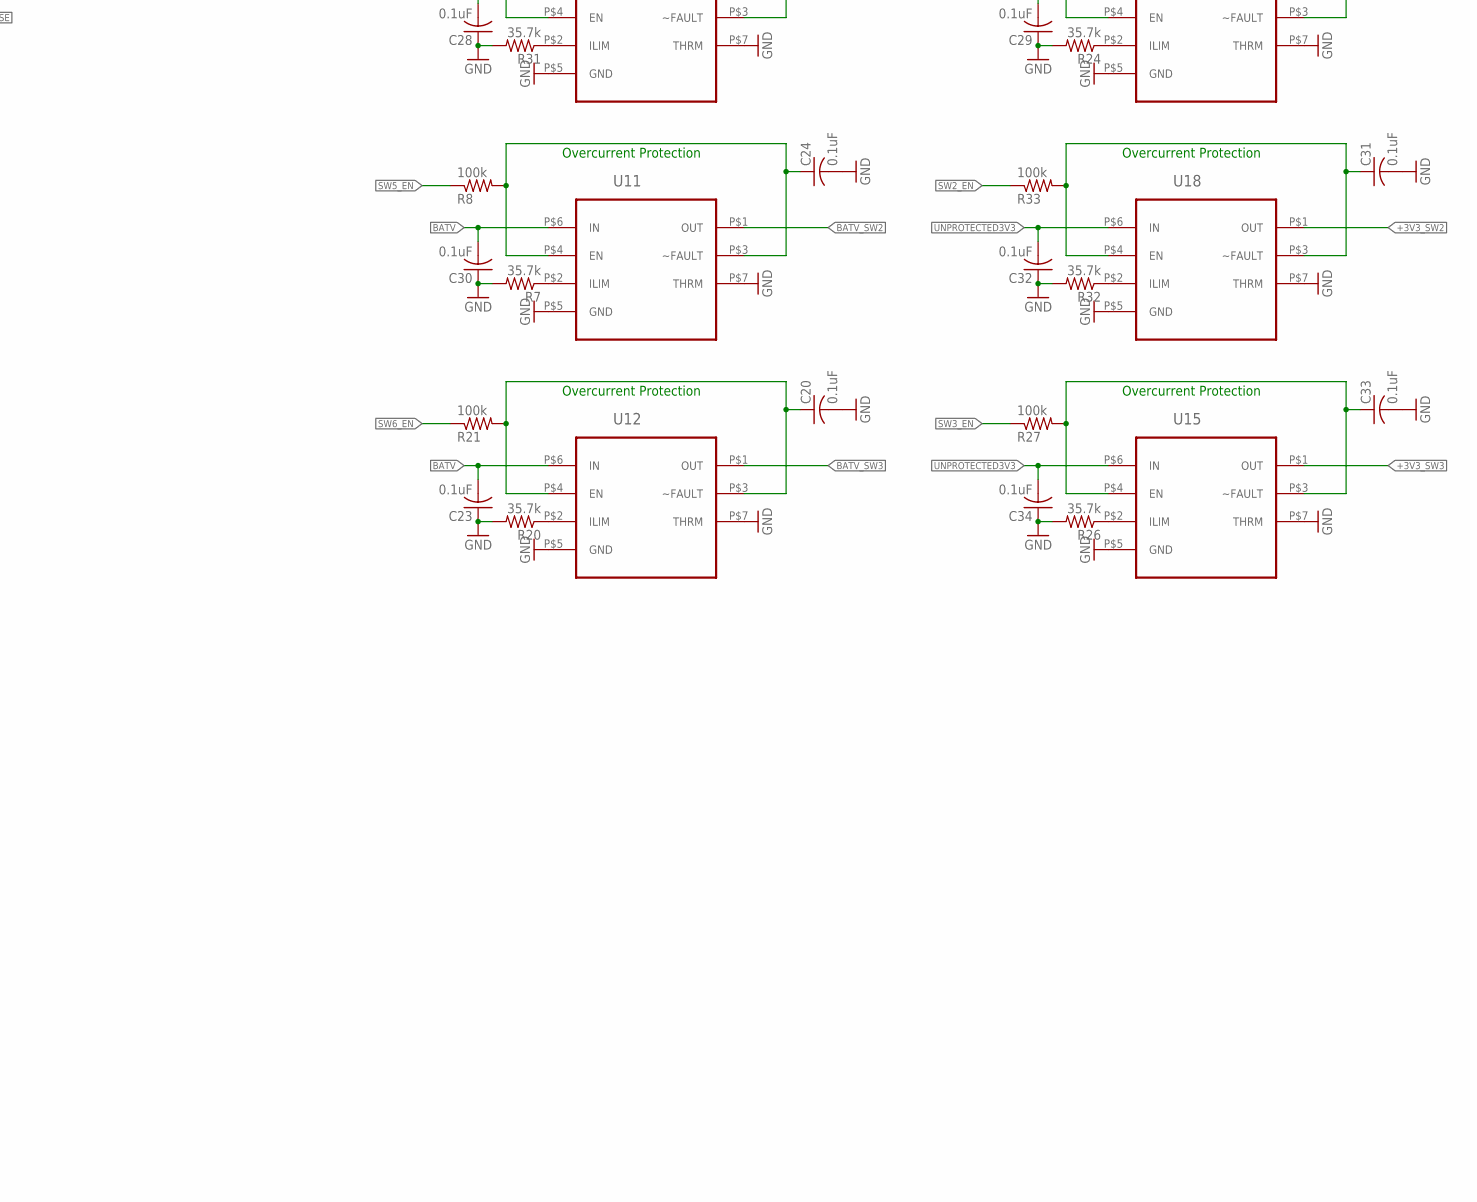
[picture p23: schematic PQ60 EPS FV4.sch, part in row 2, column 2]

Parts:
C1, C2, C3, C4, C5, C6, C9, C10: 10uF; C0805
C7, C8, C11, C12, C13, C21, C22, C35: 4.7uF; C0805
C14, C15, C16: 1uF; C0805
C17, C18, C19, C20, C23, C24, C25, C26, C27, C28, C29, C30, C31, C32, C33, C34: 0.1uF; C0805
L1, L2, L3: 10UH; IND_ELL6XH
L4: 2.2UH; IND_ELL3FU
R1, R2, R22, R23, R28: 470k; R0805
R3, R5, R8, R21, R25, R27, R30, R33: 100k; R0805
R4, R6, R7, R20, R24, R26, R31, R32: 35.7k; R0805
R9, R11, R14: 15k; R0805
R10, R12, R13: 4.7k; R0805
R15, R16, R17: 466k; R0805
R18: 787; R0805
R19: 21.5k; R0805
U1, U2, U3: LTC3105EDDPBF; DFN300X300X80-11N
U4, U5, U13, U16, U19: LTC4413EDDPBF; DFN300X300X80-11N
U6: TPS63001DRCR; SON50P300X300X100-11N
U7, U8, U11, U12, U14, U15, U17, U18: DRV
U9: BQ24210DQCT; SON50P200X300X80-11N
U10: PCA9534PW; SOP65P640X110-16N
U$1: MCP130T-315I/TT; SOT95P237X112-3N
U$2: FX8C-060S-SV(92)
U$3: FX8C-060P-SV(92)
U$4, U$5, U$6, U$7, U$8, U$9, U$10: JST-SH-02
U$11: JST-SH-03

Connections:
!RST: U$1.1 (~RST), U$2.P$27 (/RST), U$3.P$27 (/RST)
+3V3: R22.2, R23.2, R28.2, U1.4 (~SHDN), U2.4 (~SHDN), U3.4 (~SHDN), U8.P$1 (OUT), U10.16 (VDD), U$1.2 (VDD), U$2.P$57 (+3V3), U$2.P$58 (+3V3), U$2.P$59 (+3V3), U$2.P$60 (+3V3), U$3.P$57 (+3V3), U$3.P$58 (+3V3), U$3.P$59 (+3V3), U$3.P$60 (+3V3)
+3V3_SW1: U14.P$1 (OUT), U$2.P$1 (+3V3_SW1), U$2.P$2 (+3V3_SW1), U$3.P$1 (+3V3_SW1), U$3.P$2 (+3V3_SW1)
+3V3_SW2: U18.P$1 (OUT), U$2.P$5 (+3V3_SW2), U$2.P$6 (+3V3_SW2), U$3.P$5 (+3V3_SW2), U$3.P$6 (+3V3_SW2)
+3V3_SW3: U15.P$1 (OUT), U$2.P$9 (+3V3_SW3), U$2.P$10 (+3V3_SW3), U$3.P$9 (+3V3_SW3), U$3.P$10 (+3V3_SW3)
BATTERY: C9.2, C18.2, R3.2, U6.5 (VIN), U6.6 (EN), U6.7 (PS/SYNC), U6.8 (VINA), U7.P$6 (IN), U$10.P2
BATV: C23.2, C28.2, C30.2, R1.2, R2.2, U7.P$1 (OUT), U11.P$6 (IN), U12.P$6 (IN), U17.P$6 (IN), U$2.P$49 (BATV), U$2.P$50 (BATV), U$2.P$51 (BATV), U$2.P$52 (BATV), U$3.P$49 (BATV), U$3.P$50 (BATV), U$3.P$51 (BATV), U$3.P$52 (BATV)
BATV_SW1: U17.P$1 (OUT), U$2.P$13 (BATV_SW1), U$2.P$14 (BATV_SW1), U$3.P$13 (BATV_SW1), U$3.P$14 (BATV_SW1)
BATV_SW2: U11.P$1 (OUT), U$2.P$17 (BATV_SW2), U$2.P$18 (BATV_SW2), U$3.P$17 (BATV_SW2), U$3.P$18 (BATV_SW2)
BATV_SW3: U12.P$1 (OUT), U$2.P$21 (BATV_SW3), U$2.P$22 (BATV_SW3), U$3.P$21 (BATV_SW3), U$3.P$22 (BATV_SW3)
CHARGE_SENSE: U9.8 (~CHG), U10.11 (IO6)
GND: C1.1, C2.1, C3.1, C4.2, C5.2, C6.2, C7.1, C8.1, C9.1, C10.1, C11.2, C12.2, C13.2, C14.2, C15.2, C16.2, C17.2, C18.1, C19.2, C20.2, C21.1, C22.1, C23.1, C24.2, C25.2, C26.1, C27.2, C28.1, C29.1, C30.1, C31.2, C32.1, C33.2, C34.1, C35.1, R4.2, R6.2, R7.2, R10.1, R12.1, R13.1, R15.1, R16.1, R17.1, R18.1, R20.2, R24.2, R26.2, R31.2, R32.2, U1.3 (FBLDO), U1.11 (GND), U2.3 (FBLDO), U2.11 (GND), U3.3 (FBLDO), U3.11 (GND), U4.2 (ENBA), U4.3 (GND), U4.4 (ENBB), U4.11 (EP), U5.2 (ENBA), U5.3 (GND), U5.4 (ENBB), U5.11 (EP), U6.3 (PGND), U6.9 (GND), U6.11 (POWER_PAD), U7.P$5 (GND), U7.P$7 (THRM), U8.P$5 (GND), U8.P$7 (THRM), U9.3 (VSS), U9.11 (EP), U10.8 (VSS), U11.P$5 (GND), U11.P$7 (THRM), U12.P$5 (GND), U12.P$7 (THRM), U13.2 (ENBA), U13.3 (GND), U13.4 (ENBB), U13.11 (EP), U14.P$5 (GND), U14.P$7 (THRM), U15.P$5 (GND), U15.P$7 (THRM), U16.2 (ENBA), U16.3 (GND), U16.4 (ENBB), U16.11 (EP), U17.P$5 (GND), U17.P$7 (THRM), U18.P$5 (GND), U18.P$7 (THRM), U19.2 (ENBA), U19.3 (GND), U19.4 (ENBB), U19.11 (EP), U$1.3 (VSS), U$2.P$3 (RTN_+3V3_SW1), U$2.P$4 (RTN_+3V3_SW1), U$2.P$7 (RTN_+3V3_SW2), U$2.P$8 (RTN_+3V3_SW2), U$2.P$11 (RTN_+3V3_SW3), U$2.P$12 (RTN_+3V3_SW3), U$2.P$15 (RTN_BATV_SW1), U$2.P$16 (RTN_BATV_SW1), U$2.P$19 (RTN_BATV_SW2), U$2.P$20 (RTN_BATV_SW2), U$2.P$23 (RTN_BATV_SW3), U$2.P$24 (RTN_BATV_SW3), U$2.P$28 (GND), U$2.P$45 (RTN_BATV), U$2.P$46 (RTN_BATV), U$2.P$47 (RTN_BATV), U$2.P$48 (RTN_BATV), U$2.P$53 (RTN_+3V3), U$2.P$54 (RTN_+3V3), U$2.P$55 (RTN_+3V3), U$2.P$56 (RTN_+3V3), U$3.P$3 (RTN_+3V3_SW1), U$3.P$4 (RTN_+3V3_SW1), U$3.P$7 (RTN_+3V3_SW2), U$3.P$8 (RTN_+3V3_SW2), U$3.P$11 (RTN_+3V3_SW3), U$3.P$12 (RTN_+3V3_SW3), U$3.P$15 (RTN_BATV_SW1), U$3.P$16 (RTN_BATV_SW1), U$3.P$19 (RTN_BATV_SW2), U$3.P$20 (RTN_BATV_SW2), U$3.P$23 (RTN_BATV_SW3), U$3.P$24 (RTN_BATV_SW3), U$3.P$28 (GND), U$3.P$45 (RTN_BATV), U$3.P$46 (RTN_BATV), U$3.P$47 (RTN_BATV), U$3.P$48 (RTN_BATV), U$3.P$53 (RTN_+3V3), U$3.P$54 (RTN_+3V3), U$3.P$55 (RTN_+3V3), U$3.P$56 (RTN_+3V3), U$4.P2, U$5.P2, U$6.P2, U$7.P2, U$8.P2, U$9.P2, U$11.P3
GPIO0: U$2.P$25 (GPIO0), U$3.P$25 (GPIO0)
GPIO1: U$2.P$26 (GPIO1), U$3.P$26 (GPIO1)
GPIO2: U$2.P$34 (/SS/GPIO2), U$3.P$34 (/SS/GPIO2)
GPIO3: U$2.P$35 (GPIO3), U$3.P$35 (GPIO3)
GPIO4: U$2.P$36 (GPIO4), U$3.P$36 (GPIO4)
GPIO5: U$2.P$37 (GPIO5), U$3.P$37 (GPIO5)
GPIO6: U$2.P$38 (GPIO6), U$3.P$38 (GPIO6)
GPIO7: U$2.P$39 (GPIO7), U$3.P$39 (GPIO7)
GPIO8: U$2.P$40 (GPIO8), U$3.P$40 (GPIO8)
GPIO9: U$2.P$41 (GPIO9), U$3.P$41 (GPIO9)
GPIO10: U$2.P$42 (GPIO10), U$3.P$42 (GPIO10)
GPIO11: U$2.P$43 (GPIO11), U$3.P$43 (GPIO11)
GPIO12: U$2.P$44 (GPIO12), U$3.P$44 (GPIO12)
MISO: U$2.P$32 (MISO), U$3.P$32 (MISO)
MOSI: U$2.P$31 (MOSI), U$3.P$31 (MOSI)
unnamed: L2.1, U2.7 (SW)
unnamed: L3.1, U3.7 (SW)
unnamed: L1.1, U1.7 (SW)
unnamed: L4.1, U6.4 (L1)
unnamed: C4.1, R11.2, U1.9 (VOUT), U4.1 (INA)
unnamed: C5.1, R9.2, U2.9 (VOUT), U4.5 (INB)
unnamed: C6.1, R14.2, U3.9 (VOUT), U5.5 (INB)
unnamed: C17.1, R3.1, U7.P$3 (~FAULT), U7.P$4 (EN)
unnamed: C7.2, U4.6 (OUTB), U4.10 (OUTA), U5.1 (INA)
unnamed: R1.1, U5.9 (STAT)
unnamed: R2.1, U4.9 (STAT)
unnamed: L4.2, U6.2 (L2)
unnamed: R4.1, U7.P$2 (ILIM)
unnamed: R6.1, U8.P$2 (ILIM)
unnamed: C25.1, R5.1, U8.P$3 (~FAULT), U8.P$4 (EN)
unnamed: R7.1, U11.P$2 (ILIM)
unnamed: C24.1, R8.2, U11.P$3 (~FAULT), U11.P$4 (EN)
unnamed: R13.2, R14.1, U3.1 (FB)
unnamed: C11.1, U1.2 (LDO)
unnamed: C12.1, U2.2 (LDO)
unnamed: C13.1, U3.2 (LDO)
unnamed: C14.1, U2.10 (AUX)
unnamed: C15.1, U3.10 (AUX)
unnamed: C16.1, U1.10 (AUX)
unnamed: R11.1, R12.2, U1.1 (FB)
unnamed: R9.1, R10.2, U2.1 (FB)
unnamed: R31.1, U17.P$2 (ILIM)
unnamed: R15.2, U2.5 (MPPC)
unnamed: R16.2, U3.5 (MPPC)
unnamed: R17.2, U1.5 (MPPC)
unnamed: C8.2, U5.6 (OUTB), U5.10 (OUTA), U9.1 (VBUS)
unnamed: U9.6 (~PG), U9.7 (~EN)
unnamed: R18.2, U9.2 (ISET)
unnamed: U9.10 (BAT), U$10.P1, U$11.P1
unnamed: R19.2, U9.5 (TS), U$11.P2
unnamed: R19.1, U9.4 (VTSB)
unnamed: C27.1, R30.2, U17.P$3 (~FAULT), U17.P$4 (EN)
unnamed: R20.1, U12.P$2 (ILIM)
unnamed: C20.1, R21.2, U12.P$3 (~FAULT), U12.P$4 (EN)
unnamed: R23.1, U16.9 (STAT)
unnamed: R28.1, U19.9 (STAT)
unnamed: R24.1, U14.P$2 (ILIM)
unnamed: C19.1, R25.2, U14.P$3 (~FAULT), U14.P$4 (EN)
unnamed: R26.1, U15.P$2 (ILIM)
unnamed: C33.1, R27.2, U15.P$3 (~FAULT), U15.P$4 (EN)
unnamed: U13.1 (INA), U$5.P1
unnamed: U13.5 (INB), U$4.P1
unnamed: R32.1, U18.P$2 (ILIM)
unnamed: C31.1, R33.2, U18.P$3 (~FAULT), U18.P$4 (EN)
unnamed: U16.1 (INA), U$6.P1
unnamed: U16.5 (INB), U$7.P1
unnamed: U19.1 (INA), U$9.P1
unnamed: U19.5 (INB), U$8.P1
unnamed: R22.1, U13.9 (STAT)
PANEL1+2: C3.2, C21.2, L1.2, U1.6 (VIN), U13.6 (OUTB), U13.10 (OUTA)
PANEL3+4: C2.2, C22.2, L2.2, U2.6 (VIN), U16.6 (OUTB), U16.10 (OUTA)
PANEL5+6: C1.2, C35.2, L3.2, U3.6 (VIN), U19.6 (OUTB), U19.10 (OUTA)
SCK: U$2.P$33 (SCK), U$3.P$33 (SCK)
SCL: U10.14 (SCL), U$2.P$29 (SCL), U$3.P$29 (SCL)
SDA: U10.15 (SDA), U$2.P$30 (SDA), U$3.P$30 (SDA)
SW1_EN: R25.1, U10.4 (IO0)
SW2_EN: R33.1, U10.5 (IO1)
SW3_EN: R27.1, U10.6 (IO2)
SW4_EN: R30.1, U10.7 (IO3)
SW5_EN: R8.1, U10.9 (IO4)
SW6_EN: R21.1, U10.10 (IO5)
UNPROTECTED3V3: C10.2, C26.2, C29.2, C32.2, C34.2, R5.2, U6.1 (VOUT), U6.10 (FB), U8.P$6 (IN), U14.P$6 (IN), U15.P$6 (IN), U18.P$6 (IN)

Notes on the sheet:
Voltage Regulator
Voltage Supervisor
Overcurrent Protection

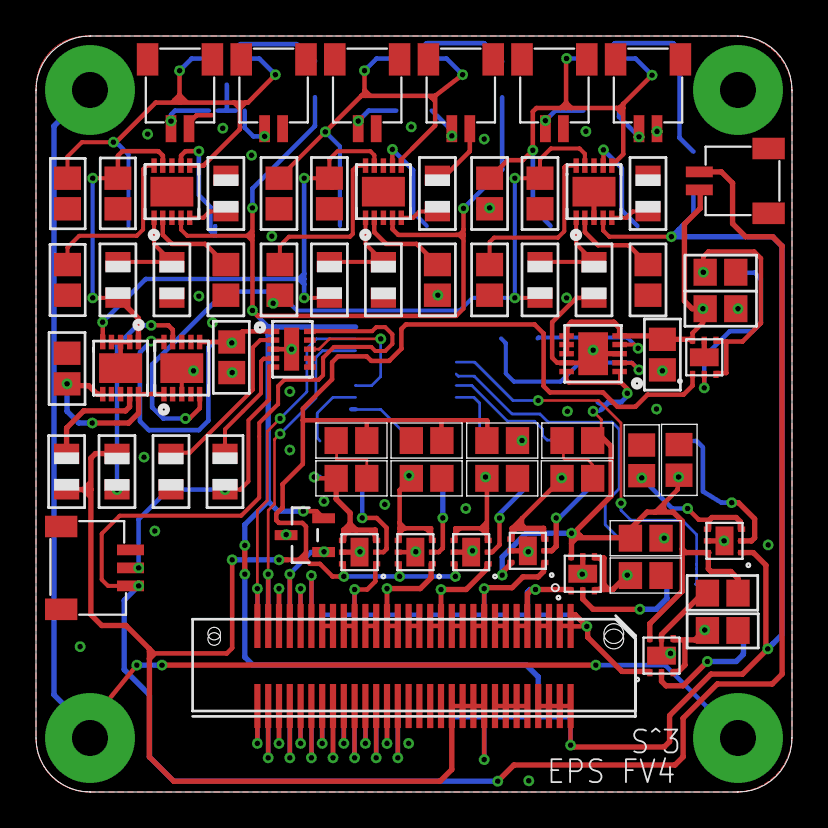
[picture p24: board PQ60 EPS FV4.brd from above]

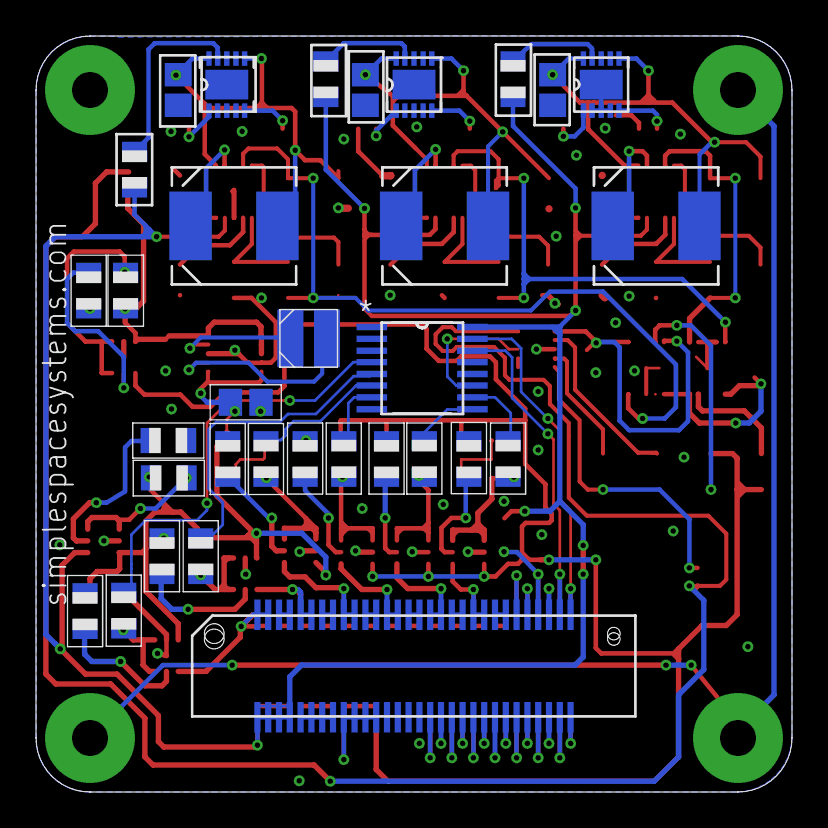
[picture p25: board PQ60 EPS FV4.brd from below]

Board: 2 copper layers, 42.0 x 42.0 mm, 101 parts (32 on the bottom side), 94 nets.
