kartikye/MySat/Schematics/Radio/Flight Model/PQ60 Radio FV1.brd

## EAGLE design Schematics/Radio/Flight Model/PQ60 Radio FV1.brd (2016-03-22)

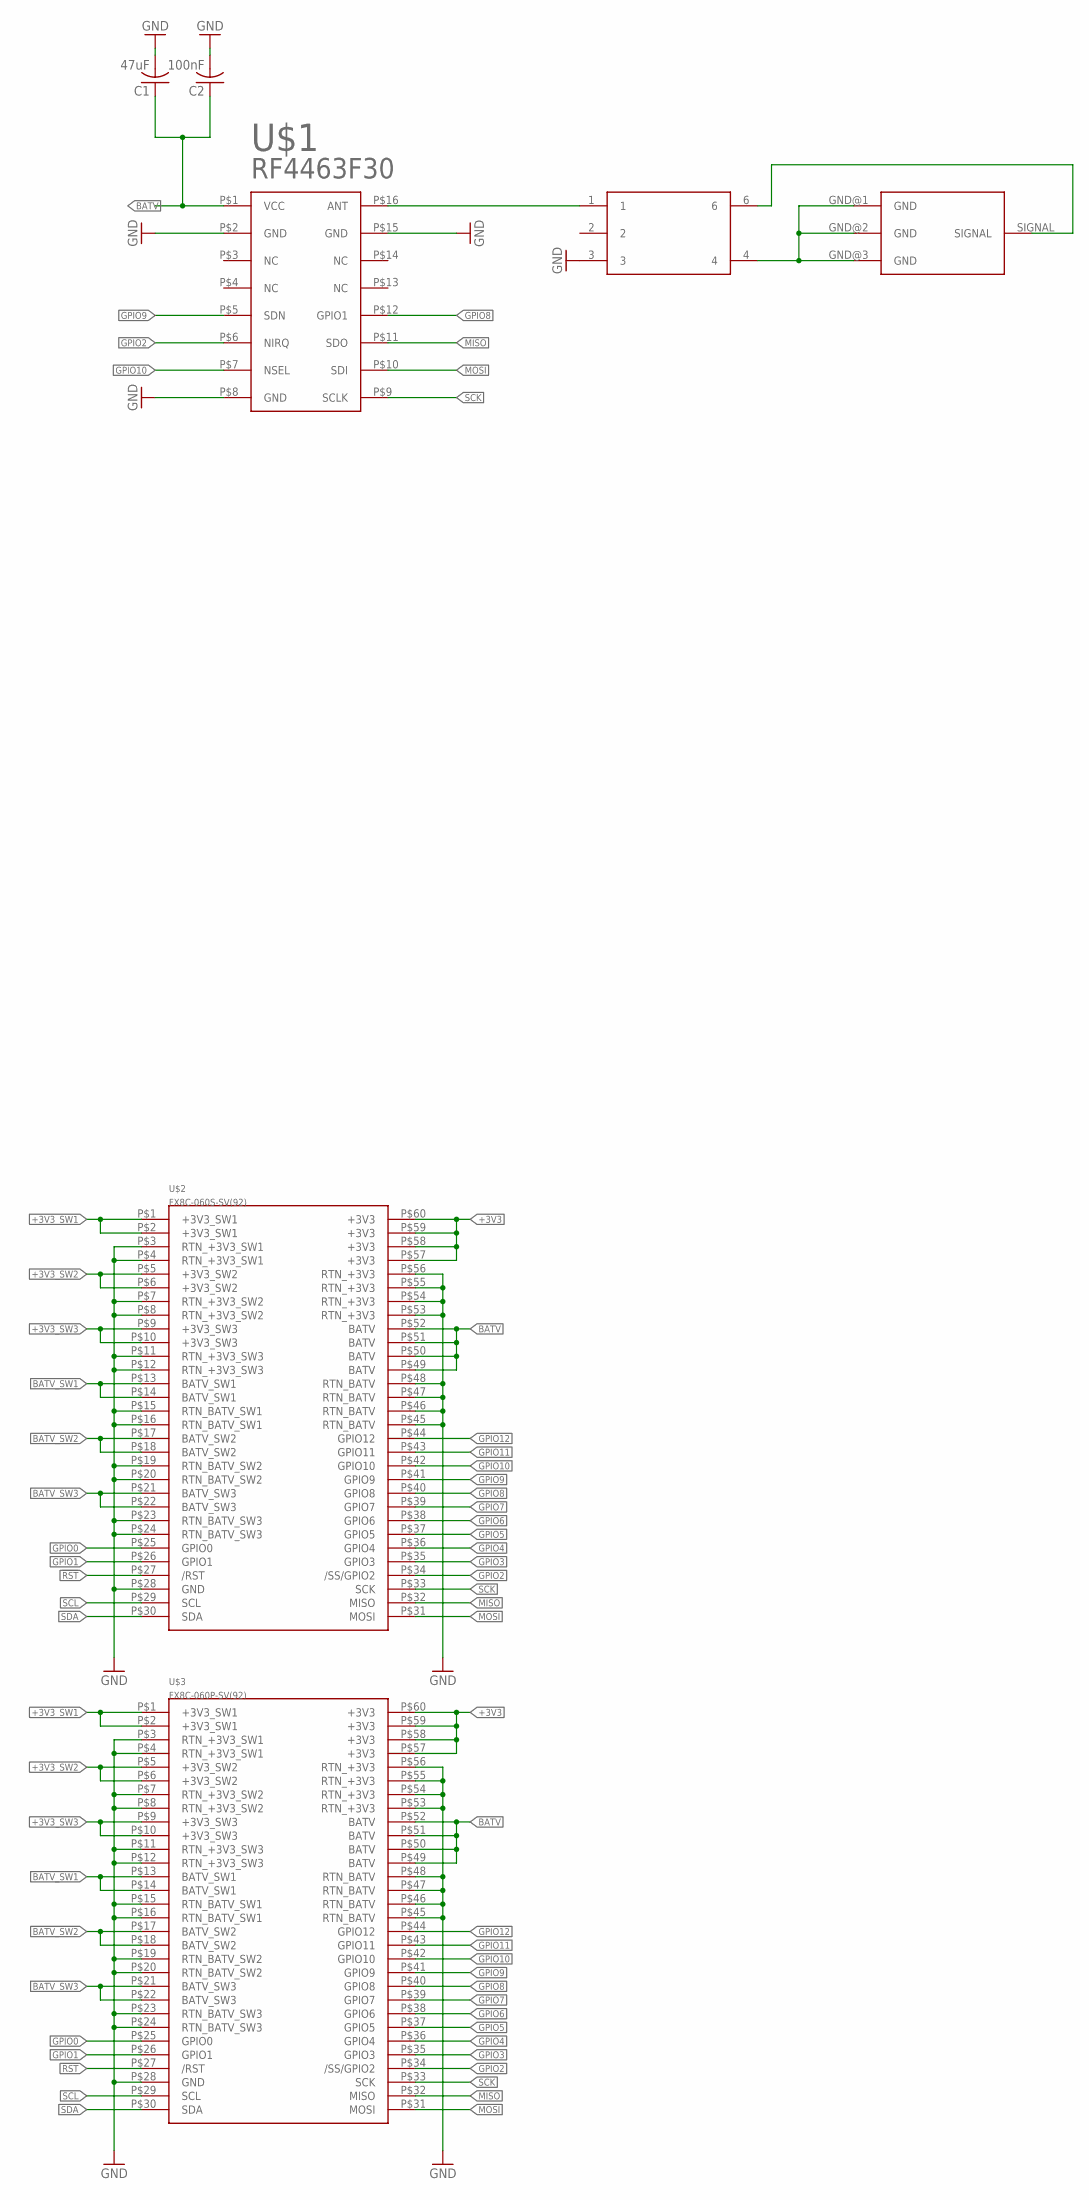
[picture p26: schematic PQ60 Radio FV1.sch]

Parts:
C1: 47uF; C0805
C2: 100nF; C0805
CX2156NL: CX2156NL
U$1: RF4463F30
U$2: FX8C-060S-SV(92)
U$3: FX8C-060P-SV(92)
U$4: MICRO-SMA

Connections:
!RST: U$2.P$27 (/RST), U$3.P$27 (/RST)
+3V3: U$2.P$57 (+3V3), U$2.P$58 (+3V3), U$2.P$59 (+3V3), U$2.P$60 (+3V3), U$3.P$57 (+3V3), U$3.P$58 (+3V3), U$3.P$59 (+3V3), U$3.P$60 (+3V3)
+3V3_SW1: U$2.P$1 (+3V3_SW1), U$2.P$2 (+3V3_SW1), U$3.P$1 (+3V3_SW1), U$3.P$2 (+3V3_SW1)
+3V3_SW2: U$2.P$5 (+3V3_SW2), U$2.P$6 (+3V3_SW2), U$3.P$5 (+3V3_SW2), U$3.P$6 (+3V3_SW2)
+3V3_SW3: U$2.P$9 (+3V3_SW3), U$2.P$10 (+3V3_SW3), U$3.P$9 (+3V3_SW3), U$3.P$10 (+3V3_SW3)
BATV: C1.1, C2.1, U$1.P$1 (VCC), U$2.P$49 (BATV), U$2.P$50 (BATV), U$2.P$51 (BATV), U$2.P$52 (BATV), U$3.P$49 (BATV), U$3.P$50 (BATV), U$3.P$51 (BATV), U$3.P$52 (BATV)
BATV_SW1: U$2.P$13 (BATV_SW1), U$2.P$14 (BATV_SW1), U$3.P$13 (BATV_SW1), U$3.P$14 (BATV_SW1)
BATV_SW2: U$2.P$17 (BATV_SW2), U$2.P$18 (BATV_SW2), U$3.P$17 (BATV_SW2), U$3.P$18 (BATV_SW2)
BATV_SW3: U$2.P$21 (BATV_SW3), U$2.P$22 (BATV_SW3), U$3.P$21 (BATV_SW3), U$3.P$22 (BATV_SW3)
GND: C1.2, C2.2, CX2156NL.3, U$1.P$2 (GND), U$1.P$8 (GND), U$1.P$15 (GND), U$2.P$3 (RTN_+3V3_SW1), U$2.P$4 (RTN_+3V3_SW1), U$2.P$7 (RTN_+3V3_SW2), U$2.P$8 (RTN_+3V3_SW2), U$2.P$11 (RTN_+3V3_SW3), U$2.P$12 (RTN_+3V3_SW3), U$2.P$15 (RTN_BATV_SW1), U$2.P$16 (RTN_BATV_SW1), U$2.P$19 (RTN_BATV_SW2), U$2.P$20 (RTN_BATV_SW2), U$2.P$23 (RTN_BATV_SW3), U$2.P$24 (RTN_BATV_SW3), U$2.P$28 (GND), U$2.P$45 (RTN_BATV), U$2.P$46 (RTN_BATV), U$2.P$47 (RTN_BATV), U$2.P$48 (RTN_BATV), U$2.P$53 (RTN_+3V3), U$2.P$54 (RTN_+3V3), U$2.P$55 (RTN_+3V3), U$2.P$56 (RTN_+3V3), U$3.P$3 (RTN_+3V3_SW1), U$3.P$4 (RTN_+3V3_SW1), U$3.P$7 (RTN_+3V3_SW2), U$3.P$8 (RTN_+3V3_SW2), U$3.P$11 (RTN_+3V3_SW3), U$3.P$12 (RTN_+3V3_SW3), U$3.P$15 (RTN_BATV_SW1), U$3.P$16 (RTN_BATV_SW1), U$3.P$19 (RTN_BATV_SW2), U$3.P$20 (RTN_BATV_SW2), U$3.P$23 (RTN_BATV_SW3), U$3.P$24 (RTN_BATV_SW3), U$3.P$28 (GND), U$3.P$45 (RTN_BATV), U$3.P$46 (RTN_BATV), U$3.P$47 (RTN_BATV), U$3.P$48 (RTN_BATV), U$3.P$53 (RTN_+3V3), U$3.P$54 (RTN_+3V3), U$3.P$55 (RTN_+3V3), U$3.P$56 (RTN_+3V3)
GPIO0: U$2.P$25 (GPIO0), U$3.P$25 (GPIO0)
GPIO1: U$2.P$26 (GPIO1), U$3.P$26 (GPIO1)
GPIO2: U$1.P$6 (NIRQ), U$2.P$34 (/SS/GPIO2), U$3.P$34 (/SS/GPIO2)
GPIO3: U$2.P$35 (GPIO3), U$3.P$35 (GPIO3)
GPIO4: U$2.P$36 (GPIO4), U$3.P$36 (GPIO4)
GPIO5: U$2.P$37 (GPIO5), U$3.P$37 (GPIO5)
GPIO6: U$2.P$38 (GPIO6), U$3.P$38 (GPIO6)
GPIO7: U$2.P$39 (GPIO7), U$3.P$39 (GPIO7)
GPIO8: U$1.P$12 (GPIO1), U$2.P$40 (GPIO8), U$3.P$40 (GPIO8)
GPIO9: U$1.P$5 (SDN), U$2.P$41 (GPIO9), U$3.P$41 (GPIO9)
GPIO10: U$1.P$7 (NSEL), U$2.P$42 (GPIO10), U$3.P$42 (GPIO10)
GPIO11: U$2.P$43 (GPIO11), U$3.P$43 (GPIO11)
GPIO12: U$2.P$44 (GPIO12), U$3.P$44 (GPIO12)
MISO: U$1.P$11 (SDO), U$2.P$32 (MISO), U$3.P$32 (MISO)
MOSI: U$1.P$10 (SDI), U$2.P$31 (MOSI), U$3.P$31 (MOSI)
unnamed: CX2156NL.1, U$1.P$16 (ANT)
unnamed: CX2156NL.6, U$4.SIGNAL
unnamed: CX2156NL.4, U$4.GND@1 (GND), U$4.GND@2 (GND), U$4.GND@3 (GND)
SCK: U$1.P$9 (SCLK), U$2.P$33 (SCK), U$3.P$33 (SCK)
SCL: U$2.P$29 (SCL), U$3.P$29 (SCL)
SDA: U$2.P$30 (SDA), U$3.P$30 (SDA)

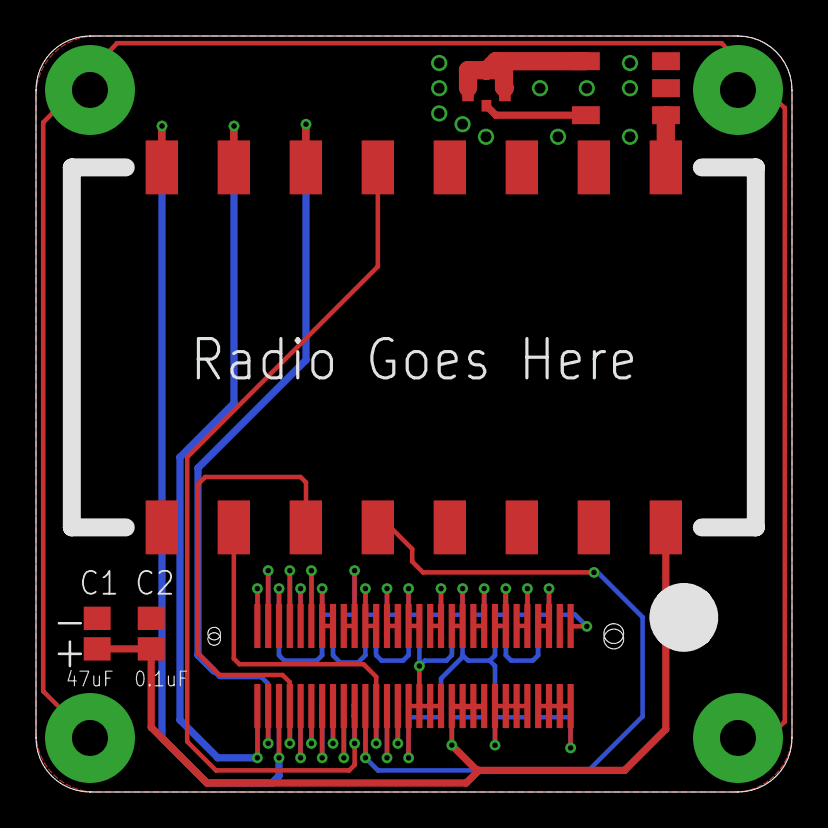
[picture p27: board PQ60 Radio FV1.brd from above]

Board: 2 copper layers, 42.0 x 42.0 mm, 7 parts (1 on the bottom side), 31 nets.
