kartikye/MySat/Schematics/Radio/Enginnering Model/Radio EV1.brd

## EAGLE design Schematics/Radio/Enginnering Model/Radio EV1.brd (2016-03-22)

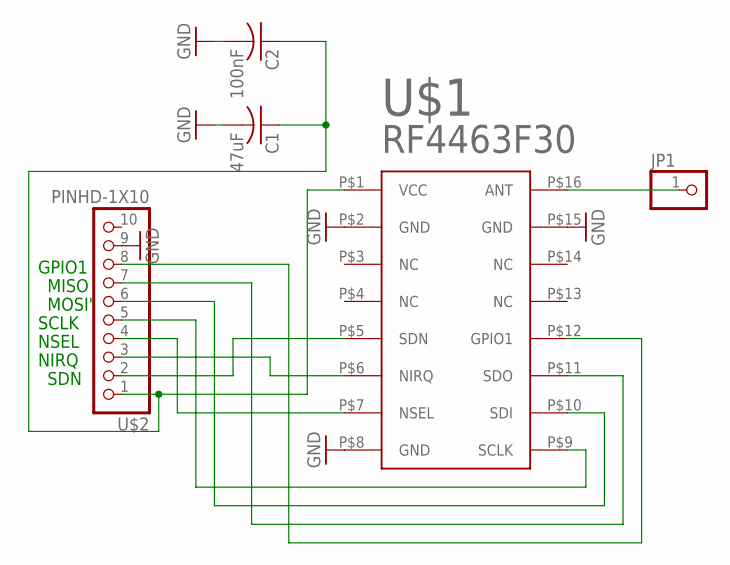
[picture p28: schematic Radio EV1.sch]

Parts:
C1: 47uF; C0805
C2: 100nF; C0805
JP1: PINHD-1X1CB; 1X01-CLEANBIG
U$1: RF4463F30
U$2: PINHD-1X10; 1X10-BIG

Connections:
GND: C1.2, C2.2, U$1.P$2 (GND), U$1.P$8 (GND), U$1.P$15 (GND), U$2.9
GPIO1: U$1.P$12 (GPIO1), U$2.8
unnamed: JP1.1, U$1.P$16 (ANT)
NIRQ: U$1.P$6 (NIRQ), U$2.3
NSEL: U$1.P$7 (NSEL), U$2.4
SCLK: U$1.P$9 (SCLK), U$2.5
SDI: U$1.P$10 (SDI), U$2.6
SDN: U$1.P$5 (SDN), U$2.2
SDO: U$1.P$11 (SDO), U$2.7
VCC: C1.1, C2.1, U$1.P$1 (VCC), U$2.1

Notes on the sheet:
SDN
NIRQ
NSEL
SCLK
MOSI'
MISO
GPIO1

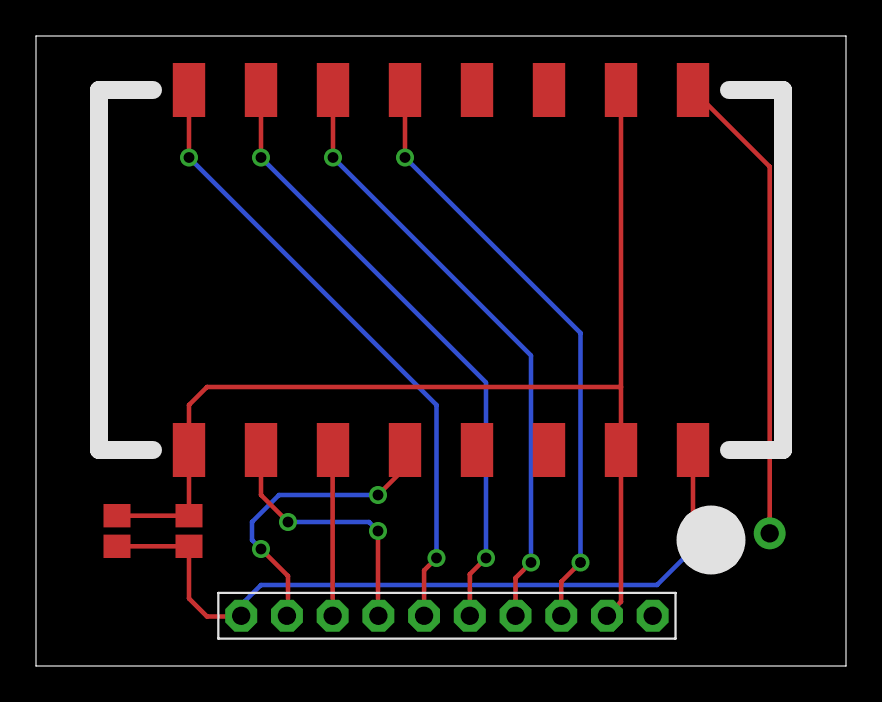
[picture p29: board Radio EV1.brd from above]

Board: 2 copper layers, 45.0 x 35.0 mm, 5 parts (0 on the bottom side), 10 nets.
