kartikye/MySat/Schematics/CB/Flight Model/PQ60 CB FV2.brd

## EAGLE design Schematics/CB/Flight Model/PQ60 CB FV2.brd (2016-03-22)

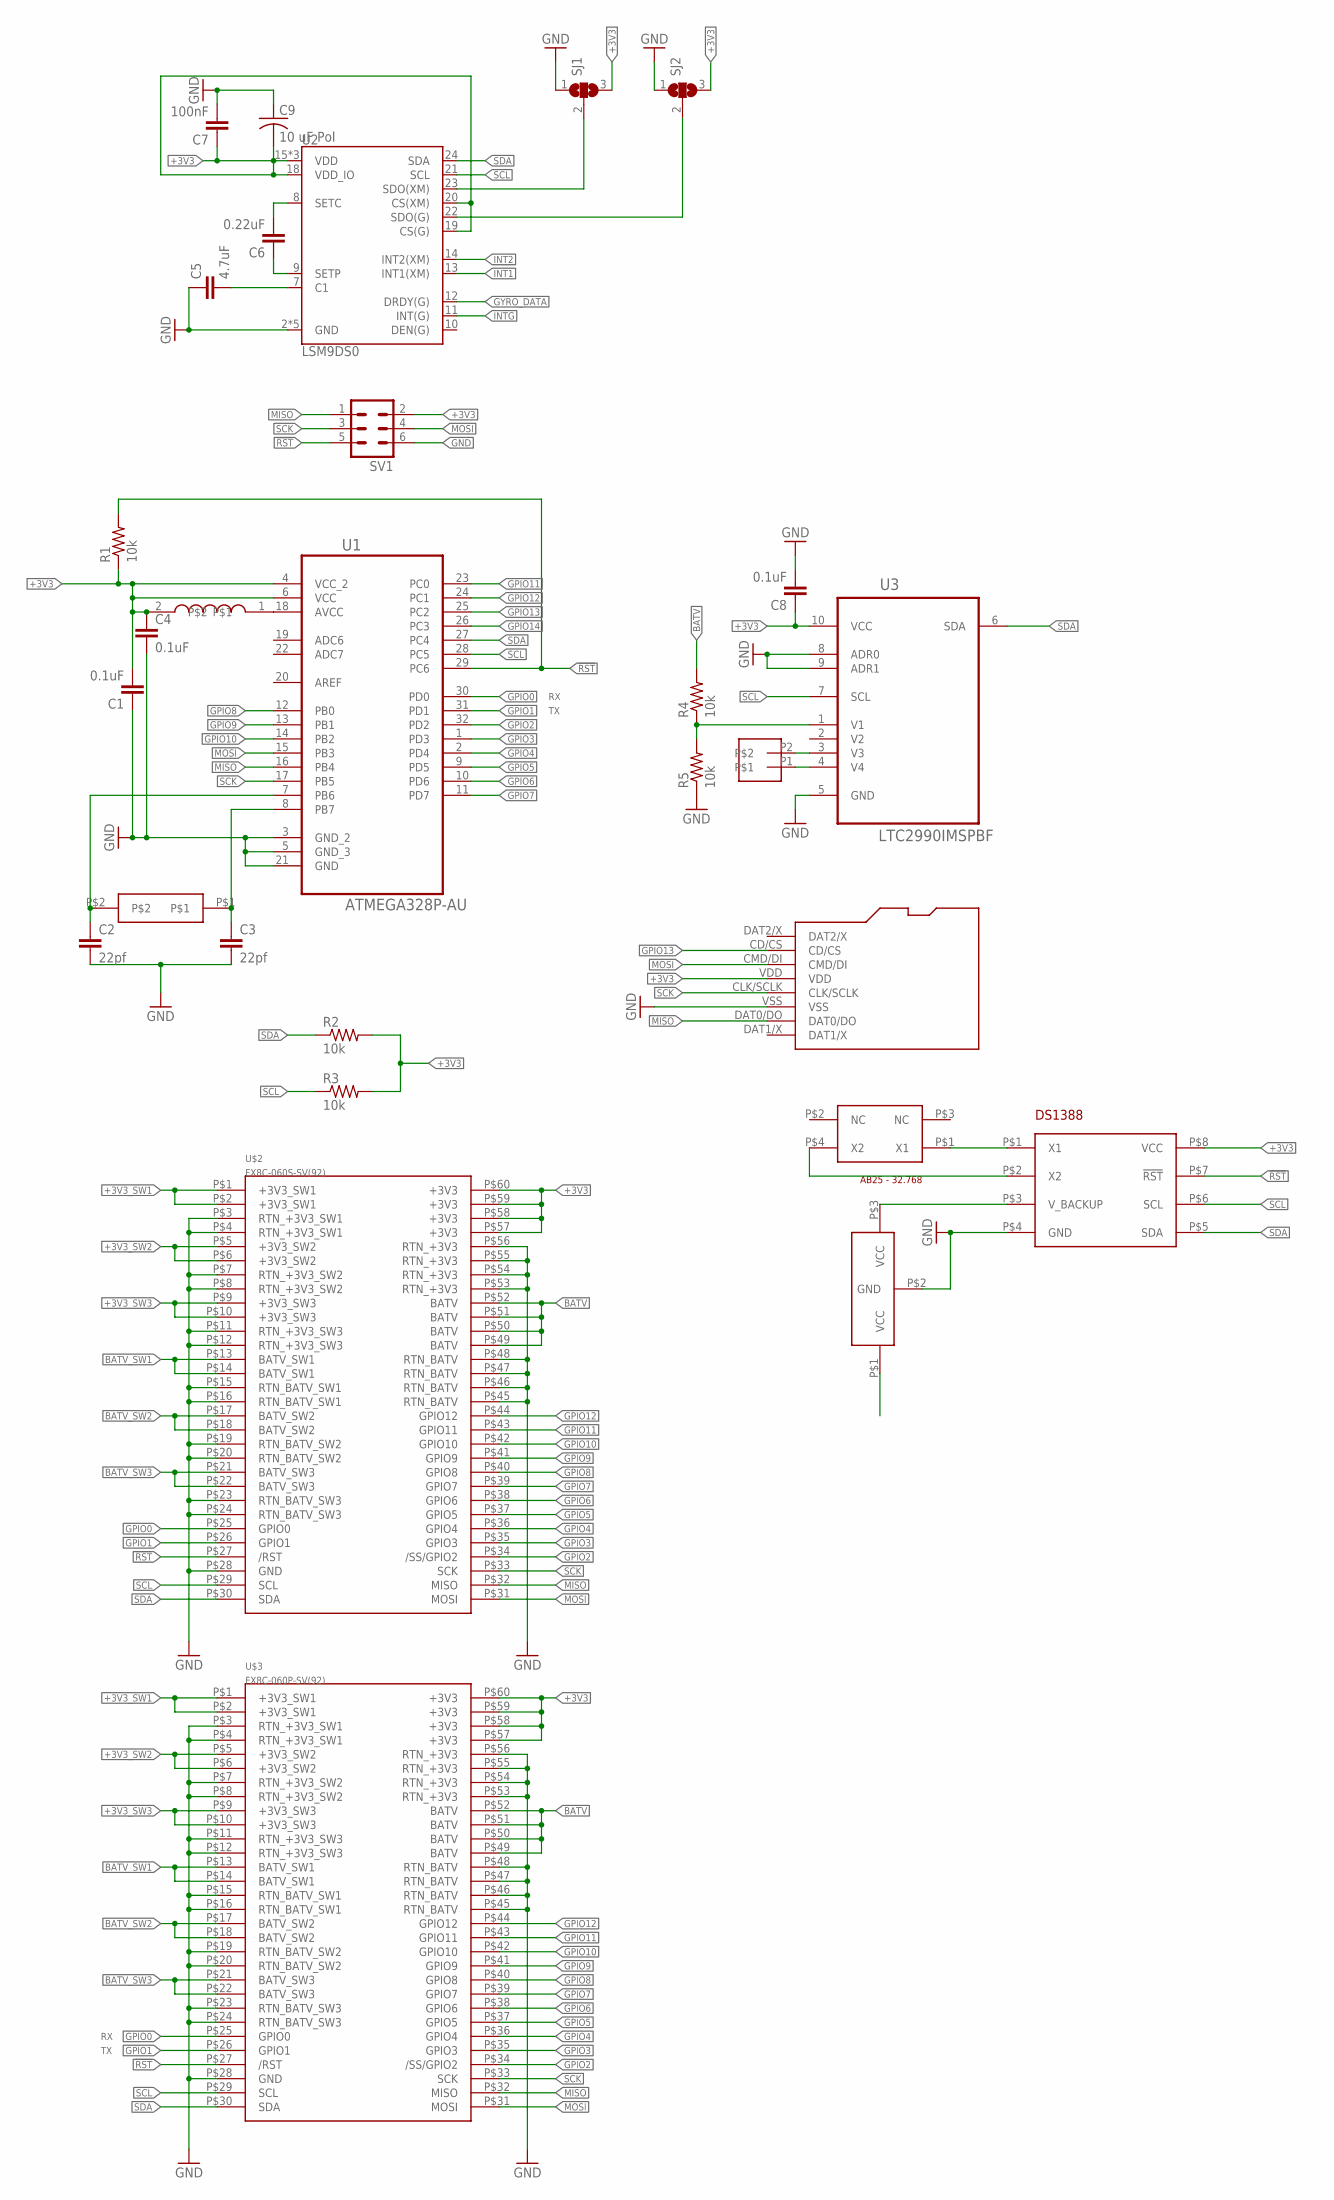
[picture p30: schematic PQ60 CB FV2.sch]

Parts:
C1, C4, C8: 0.1uF; C0805
C2, C3: 22pf; C0805
C5: 4.7uF; C0805
C6: 0.22uF; C0805
C7: 100nF; C0805
C9: 10 uF Pol; C0805
R1: 10k; R0805
R2, R3, R4, R5: 10k; M0805
SJ1, SJ2: SJ2W; SJ_2
SV1: MA03-2
U1: ATMEGA328P-AU; QFP80P900X900X120-32N
U2: LSM9DS0; LGA-24
U3: LTC2990IMSPBF; SOP50P490X110-10N
U$2: FX8C-060S-SV(92)
U$3: FX8C-060P-SV(92)
U$4: AB3-47699; ABM#-47699
U$5: 1210-047J
U$6: MICROSD
U$7: JST-SH-02
U$8: DS1388
U$9: AB25; ABS25
U$10: 6.8MM-BATTERY

Connections:
!RST: R1.2, SV1.5, U1.29 (PC6), U$2.P$27 (/RST), U$3.P$27 (/RST), U$8.P$7 (!RST)
+3V3: C1.2, C4.1, C7.1, C8.1, C9.2, R1.1, R2.2, R3.2, SJ1.3, SJ2.3, SV1.2, U1.4 (VCC_2), U1.6 (VCC), U2.15 (VDD), U2.16 (VDD), U2.17 (VDD), U2.18 (VDD_IO), U2.19 (CS(G)), U2.20 (CS(XM)), U3.10 (VCC), U$2.P$57 (+3V3), U$2.P$58 (+3V3), U$2.P$59 (+3V3), U$2.P$60 (+3V3), U$3.P$57 (+3V3), U$3.P$58 (+3V3), U$3.P$59 (+3V3), U$3.P$60 (+3V3), U$5.2, U$6.VDD, U$8.P$8 (VCC)
+3V3_SW1: U$2.P$1 (+3V3_SW1), U$2.P$2 (+3V3_SW1), U$3.P$1 (+3V3_SW1), U$3.P$2 (+3V3_SW1)
+3V3_SW2: U$2.P$5 (+3V3_SW2), U$2.P$6 (+3V3_SW2), U$3.P$5 (+3V3_SW2), U$3.P$6 (+3V3_SW2)
+3V3_SW3: U$2.P$9 (+3V3_SW3), U$2.P$10 (+3V3_SW3), U$3.P$9 (+3V3_SW3), U$3.P$10 (+3V3_SW3)
BATV: R4.2, U$2.P$49 (BATV), U$2.P$50 (BATV), U$2.P$51 (BATV), U$2.P$52 (BATV), U$3.P$49 (BATV), U$3.P$50 (BATV), U$3.P$51 (BATV), U$3.P$52 (BATV)
BATV_SW1: U$2.P$13 (BATV_SW1), U$2.P$14 (BATV_SW1), U$3.P$13 (BATV_SW1), U$3.P$14 (BATV_SW1)
BATV_SW2: U$2.P$17 (BATV_SW2), U$2.P$18 (BATV_SW2), U$3.P$17 (BATV_SW2), U$3.P$18 (BATV_SW2)
BATV_SW3: U$2.P$21 (BATV_SW3), U$2.P$22 (BATV_SW3), U$3.P$21 (BATV_SW3), U$3.P$22 (BATV_SW3)
GND: C1.1, C2.2, C3.2, C4.2, C5.1, C7.2, C8.2, C9.1, R5.1, SJ1.1, SJ2.1, SV1.6, U1.3 (GND_2), U1.5 (GND_3), U1.21 (GND), U2.2 (GND), U2.3 (GND), U2.4 (GND), U2.5 (GND), U2.6 (GND), U3.5 (GND), U3.8 (ADR0), U3.9 (ADR1), U$2.P$3 (RTN_+3V3_SW1), U$2.P$4 (RTN_+3V3_SW1), U$2.P$7 (RTN_+3V3_SW2), U$2.P$8 (RTN_+3V3_SW2), U$2.P$11 (RTN_+3V3_SW3), U$2.P$12 (RTN_+3V3_SW3), U$2.P$15 (RTN_BATV_SW1), U$2.P$16 (RTN_BATV_SW1), U$2.P$19 (RTN_BATV_SW2), U$2.P$20 (RTN_BATV_SW2), U$2.P$23 (RTN_BATV_SW3), U$2.P$24 (RTN_BATV_SW3), U$2.P$28 (GND), U$2.P$45 (RTN_BATV), U$2.P$46 (RTN_BATV), U$2.P$47 (RTN_BATV), U$2.P$48 (RTN_BATV), U$2.P$53 (RTN_+3V3), U$2.P$54 (RTN_+3V3), U$2.P$55 (RTN_+3V3), U$2.P$56 (RTN_+3V3), U$3.P$3 (RTN_+3V3_SW1), U$3.P$4 (RTN_+3V3_SW1), U$3.P$7 (RTN_+3V3_SW2), U$3.P$8 (RTN_+3V3_SW2), U$3.P$11 (RTN_+3V3_SW3), U$3.P$12 (RTN_+3V3_SW3), U$3.P$15 (RTN_BATV_SW1), U$3.P$16 (RTN_BATV_SW1), U$3.P$19 (RTN_BATV_SW2), U$3.P$20 (RTN_BATV_SW2), U$3.P$23 (RTN_BATV_SW3), U$3.P$24 (RTN_BATV_SW3), U$3.P$28 (GND), U$3.P$45 (RTN_BATV), U$3.P$46 (RTN_BATV), U$3.P$47 (RTN_BATV), U$3.P$48 (RTN_BATV), U$3.P$53 (RTN_+3V3), U$3.P$54 (RTN_+3V3), U$3.P$55 (RTN_+3V3), U$3.P$56 (RTN_+3V3), U$6.VSS, U$8.P$4 (GND), U$10.P$2 (GND)
GPIO0: U1.30 (PD0), U$2.P$25 (GPIO0), U$3.P$25 (GPIO0)
GPIO1: U1.31 (PD1), U$2.P$26 (GPIO1), U$3.P$26 (GPIO1)
GPIO2: U1.32 (PD2), U$2.P$34 (/SS/GPIO2), U$3.P$34 (/SS/GPIO2)
GPIO3: U1.1 (PD3), U$2.P$35 (GPIO3), U$3.P$35 (GPIO3)
GPIO4: U1.2 (PD4), U$2.P$36 (GPIO4), U$3.P$36 (GPIO4)
GPIO5: U1.9 (PD5), U$2.P$37 (GPIO5), U$3.P$37 (GPIO5)
GPIO6: U1.10 (PD6), U$2.P$38 (GPIO6), U$3.P$38 (GPIO6)
GPIO7: U1.11 (PD7), U$2.P$39 (GPIO7), U$3.P$39 (GPIO7)
GPIO8: U1.12 (PB0), U$2.P$40 (GPIO8), U$3.P$40 (GPIO8)
GPIO9: U1.13 (PB1), U$2.P$41 (GPIO9), U$3.P$41 (GPIO9)
GPIO10: U1.14 (PB2), U$2.P$42 (GPIO10), U$3.P$42 (GPIO10)
GPIO11: U1.23 (PC0), U$2.P$43 (GPIO11), U$3.P$43 (GPIO11)
GPIO12: U1.24 (PC1), U$2.P$44 (GPIO12), U$3.P$44 (GPIO12)
GPIO13: U1.25 (PC2), U$6.CD/CS
GPIO14: U1.26 (PC3)
GYRO_DATA: U2.12 (DRDY(G))
INT1: U2.13 (INT1(XM))
INT2: U2.14 (INT2(XM))
INTG: U2.11 (INT(G))
MISO: SV1.1, U1.16 (PB4), U$2.P$32 (MISO), U$3.P$32 (MISO), U$6.DAT0/DO
MOSI: SV1.4, U1.15 (PB3), U$2.P$31 (MOSI), U$3.P$31 (MOSI), U$6.CMD/DI
unnamed: R4.1, R5.2, U3.1 (V1)
unnamed: C3.1, U1.8 (PB7), U$4.P$1
unnamed: C2.1, U1.7 (PB6), U$4.P$2
unnamed: U1.18 (AVCC), U$5.1
unnamed: C5.2, U2.7 (C1)
unnamed: C6.2, U2.8 (SETC)
unnamed: C6.1, U2.9 (SETP)
unnamed: SJ1.2, U2.23 (SDO(XM))
unnamed: SJ2.2, U2.22 (SDO(G))
unnamed: U3.3 (V3), U$7.P2
unnamed: U3.4 (V4), U$7.P1
unnamed: U$8.P$1 (X1), U$9.P$1 (X1)
unnamed: U$8.P$2 (X2), U$9.P$4 (X2)
unnamed: U$8.P$3 (V_BACKUP), U$10.P$3 (VCC)
SCK: SV1.3, U1.17 (PB5), U$2.P$33 (SCK), U$3.P$33 (SCK), U$6.CLK/SCLK
SCL: R3.1, U1.28 (PC5), U2.21 (SCL), U3.7 (SCL), U$2.P$29 (SCL), U$3.P$29 (SCL), U$8.P$6 (SCL)
SDA: R2.1, U1.27 (PC4), U2.24 (SDA), U3.6 (SDA), U$2.P$30 (SDA), U$3.P$30 (SDA), U$8.P$5 (SDA)

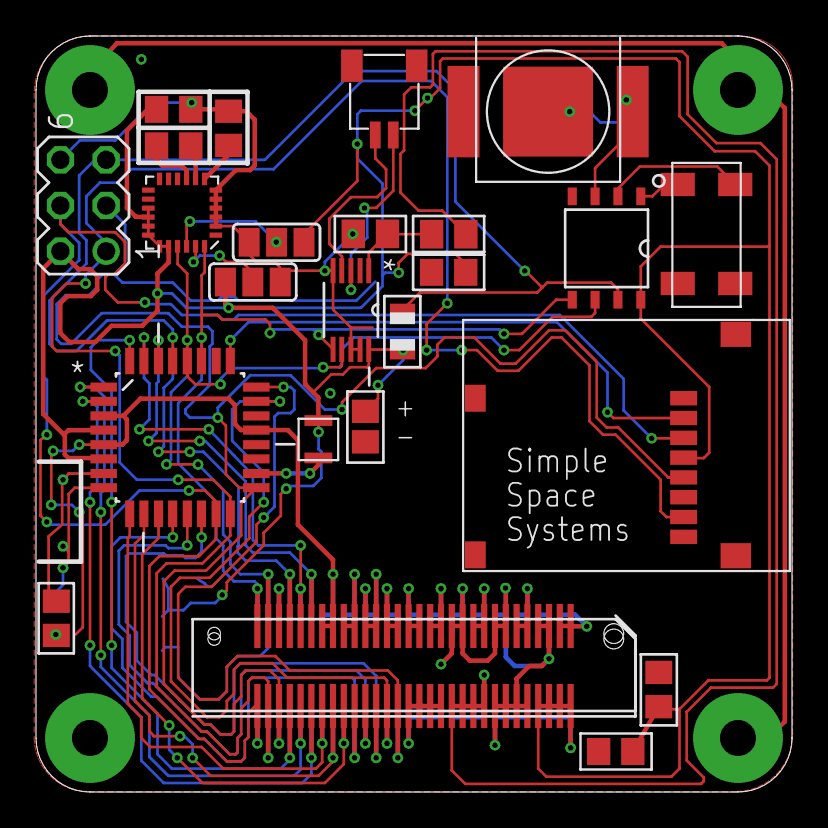
[picture p31: board PQ60 CB FV2.brd from above]

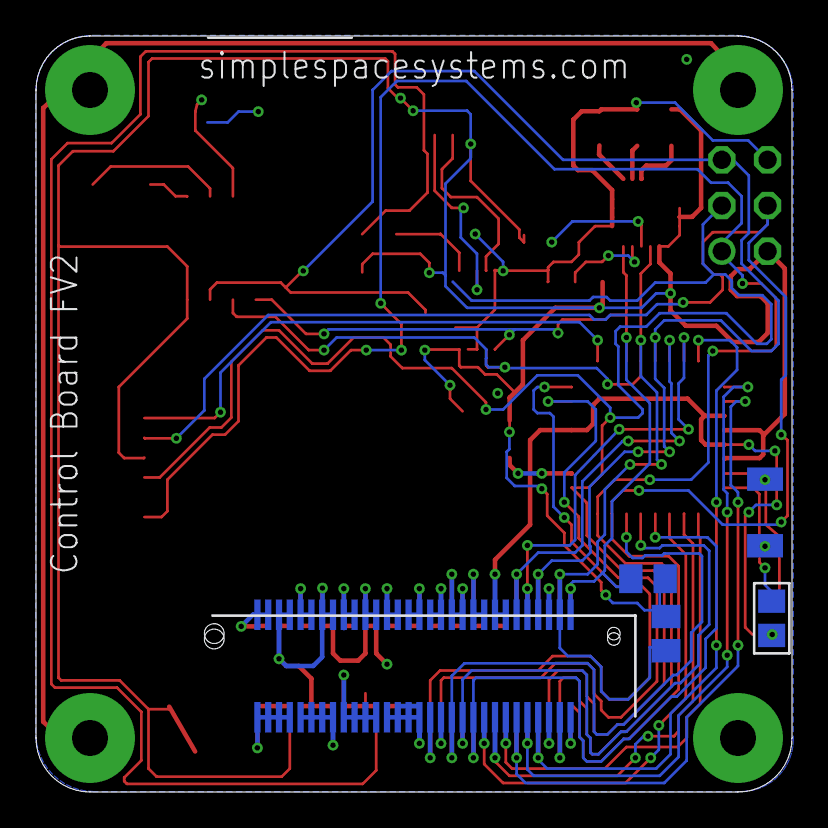
[picture p32: board PQ60 CB FV2.brd from below]

Board: 2 copper layers, 42.0 x 42.0 mm, 29 parts (5 on the bottom side), 43 nets.
