kartikye/MySat/Schematics/Rad Sensor/Rad Sensor EV 1.brd

## EAGLE design Schematics/Rad Sensor/Rad Sensor EV 1.brd (2015-12-20)

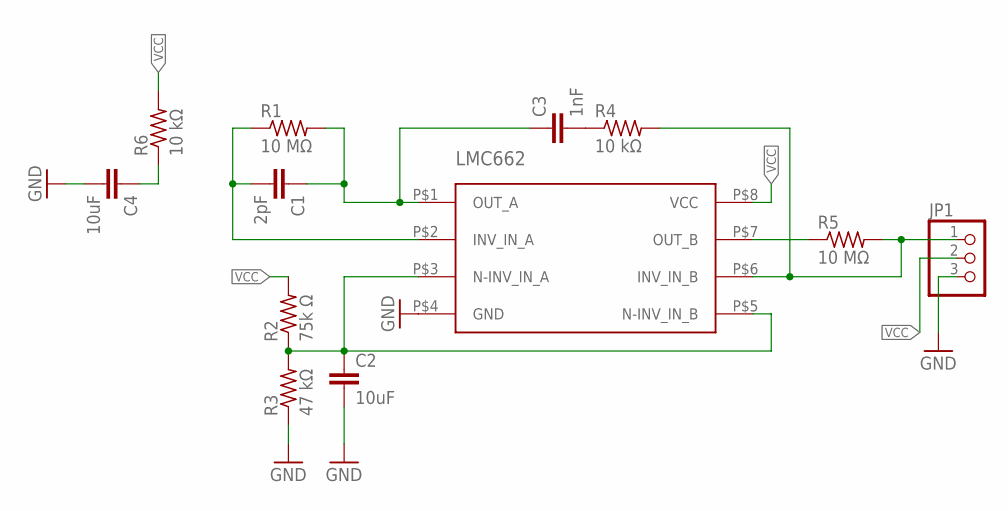
[picture p33: schematic Rad Sensor EV 1.sch]

Parts:
C1: 2pF; C0805
C2, C4: 10uF; C0805
C3: 1nF; C0805
JP1: PINHD-1X3; 1X03
R1, R5: 10 MΩ; R0805
R2: 75k Ω; R0805
R3: 47 kΩ; R0805
R4, R6: 10 kΩ; R0805
U$1: LMC662

Connections:
GND: C2.2, C4.2, JP1.3, R3.1, U$1.P$4 (GND)
unnamed: C1.2, R1.1, U$1.P$2 (INV_IN_A)
unnamed: C1.1, C3.1, R1.2, U$1.P$1 (OUT_A)
unnamed: C3.2, R4.1
unnamed: C2.1, R2.1, R3.2, U$1.P$3 (N-INV_IN_A), U$1.P$5 (N-INV_IN_B)
unnamed: R5.1, U$1.P$7 (OUT_B)
unnamed: JP1.1, R4.2, R5.2, U$1.P$6 (INV_IN_B)
unnamed: C4.1, R6.1
VCC: JP1.2, R2.2, R6.2, U$1.P$8 (VCC)

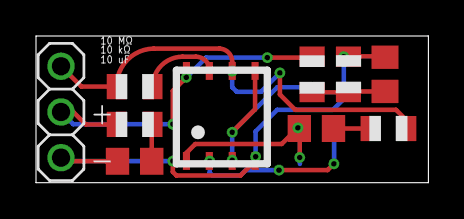
[picture p34: board Rad Sensor EV 1.brd from above]

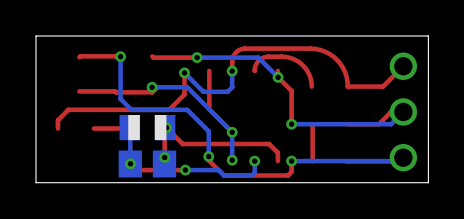
[picture p35: board Rad Sensor EV 1.brd from below]

Board: 2 copper layers, 21.8 x 8.2 mm, 12 parts (2 on the bottom side), 9 nets.
