kartikye/MySat/Schematics/FlatSat/flatsat.brd

## EAGLE design Schematics/FlatSat/flatsat.brd (2015-12-20)

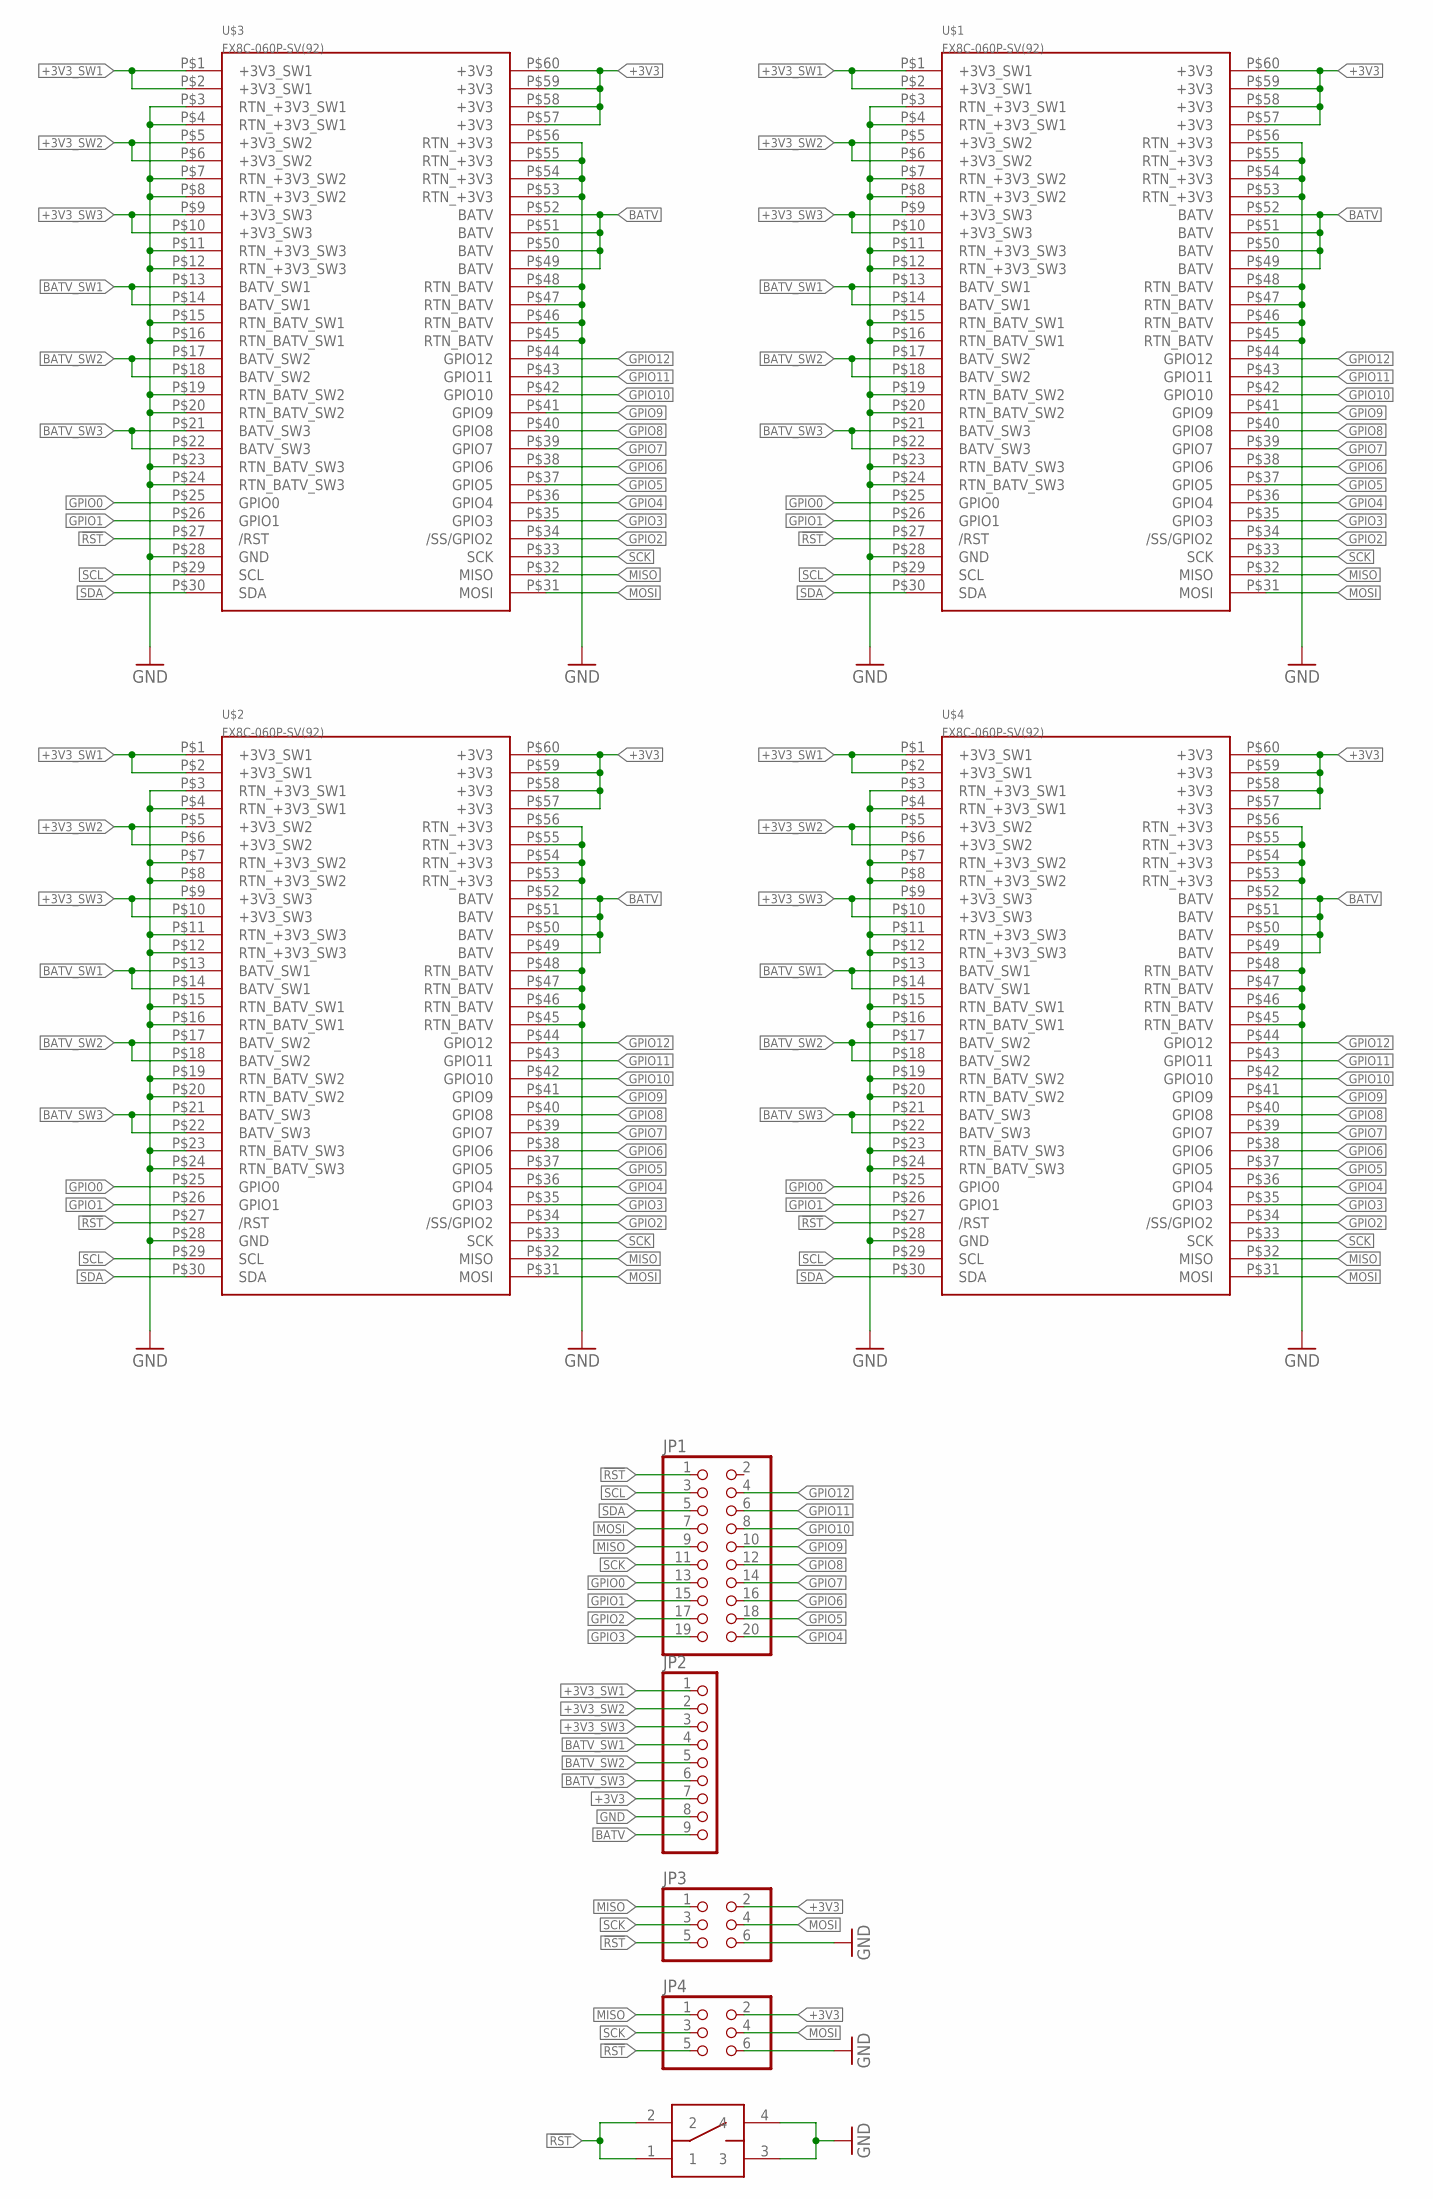
[picture p36: schematic flatsat.sch]

Parts:
JP1: PINHD-2X10; 2X10
JP2: PINHD-1X9; 1X09
JP3, JP4: PINHD-2X3; 2X03
U$1, U$2, U$3, U$4: FX8C-060P-SV(92)
U$5: SWITCH-TL3301

Connections:
!RST: JP1.1, JP3.5, JP4.5, U$1.P$27 (/RST), U$2.P$27 (/RST), U$3.P$27 (/RST), U$4.P$27 (/RST), U$5.1, U$5.2
+3V3: JP2.7, JP3.2, JP4.2, U$1.P$57 (+3V3), U$1.P$58 (+3V3), U$1.P$59 (+3V3), U$1.P$60 (+3V3), U$2.P$57 (+3V3), U$2.P$58 (+3V3), U$2.P$59 (+3V3), U$2.P$60 (+3V3), U$3.P$57 (+3V3), U$3.P$58 (+3V3), U$3.P$59 (+3V3), U$3.P$60 (+3V3), U$4.P$57 (+3V3), U$4.P$58 (+3V3), U$4.P$59 (+3V3), U$4.P$60 (+3V3)
+3V3_SW1: JP2.1, U$1.P$1 (+3V3_SW1), U$1.P$2 (+3V3_SW1), U$2.P$1 (+3V3_SW1), U$2.P$2 (+3V3_SW1), U$3.P$1 (+3V3_SW1), U$3.P$2 (+3V3_SW1), U$4.P$1 (+3V3_SW1), U$4.P$2 (+3V3_SW1)
+3V3_SW2: JP2.2, U$1.P$5 (+3V3_SW2), U$1.P$6 (+3V3_SW2), U$2.P$5 (+3V3_SW2), U$2.P$6 (+3V3_SW2), U$3.P$5 (+3V3_SW2), U$3.P$6 (+3V3_SW2), U$4.P$5 (+3V3_SW2), U$4.P$6 (+3V3_SW2)
+3V3_SW3: JP2.3, U$1.P$9 (+3V3_SW3), U$1.P$10 (+3V3_SW3), U$2.P$9 (+3V3_SW3), U$2.P$10 (+3V3_SW3), U$3.P$9 (+3V3_SW3), U$3.P$10 (+3V3_SW3), U$4.P$9 (+3V3_SW3), U$4.P$10 (+3V3_SW3)
BATV: JP2.9, U$1.P$49 (BATV), U$1.P$50 (BATV), U$1.P$51 (BATV), U$1.P$52 (BATV), U$2.P$49 (BATV), U$2.P$50 (BATV), U$2.P$51 (BATV), U$2.P$52 (BATV), U$3.P$49 (BATV), U$3.P$50 (BATV), U$3.P$51 (BATV), U$3.P$52 (BATV), U$4.P$49 (BATV), U$4.P$50 (BATV), U$4.P$51 (BATV), U$4.P$52 (BATV)
BATV_SW1: JP2.4, U$1.P$13 (BATV_SW1), U$1.P$14 (BATV_SW1), U$2.P$13 (BATV_SW1), U$2.P$14 (BATV_SW1), U$3.P$13 (BATV_SW1), U$3.P$14 (BATV_SW1), U$4.P$13 (BATV_SW1), U$4.P$14 (BATV_SW1)
BATV_SW2: JP2.5, U$1.P$17 (BATV_SW2), U$1.P$18 (BATV_SW2), U$2.P$17 (BATV_SW2), U$2.P$18 (BATV_SW2), U$3.P$17 (BATV_SW2), U$3.P$18 (BATV_SW2), U$4.P$17 (BATV_SW2), U$4.P$18 (BATV_SW2)
BATV_SW3: JP2.6, U$1.P$21 (BATV_SW3), U$1.P$22 (BATV_SW3), U$2.P$21 (BATV_SW3), U$2.P$22 (BATV_SW3), U$3.P$21 (BATV_SW3), U$3.P$22 (BATV_SW3), U$4.P$21 (BATV_SW3), U$4.P$22 (BATV_SW3)
GND: JP2.8, JP3.6, JP4.6, U$1.P$3 (RTN_+3V3_SW1), U$1.P$4 (RTN_+3V3_SW1), U$1.P$7 (RTN_+3V3_SW2), U$1.P$8 (RTN_+3V3_SW2), U$1.P$11 (RTN_+3V3_SW3), U$1.P$12 (RTN_+3V3_SW3), U$1.P$15 (RTN_BATV_SW1), U$1.P$16 (RTN_BATV_SW1), U$1.P$19 (RTN_BATV_SW2), U$1.P$20 (RTN_BATV_SW2), U$1.P$23 (RTN_BATV_SW3), U$1.P$24 (RTN_BATV_SW3), U$1.P$28 (GND), U$1.P$45 (RTN_BATV), U$1.P$46 (RTN_BATV), U$1.P$47 (RTN_BATV), U$1.P$48 (RTN_BATV), U$1.P$53 (RTN_+3V3), U$1.P$54 (RTN_+3V3), U$1.P$55 (RTN_+3V3), U$1.P$56 (RTN_+3V3), U$2.P$3 (RTN_+3V3_SW1), U$2.P$4 (RTN_+3V3_SW1), U$2.P$7 (RTN_+3V3_SW2), U$2.P$8 (RTN_+3V3_SW2), U$2.P$11 (RTN_+3V3_SW3), U$2.P$12 (RTN_+3V3_SW3), U$2.P$15 (RTN_BATV_SW1), U$2.P$16 (RTN_BATV_SW1), U$2.P$19 (RTN_BATV_SW2), U$2.P$20 (RTN_BATV_SW2), U$2.P$23 (RTN_BATV_SW3), U$2.P$24 (RTN_BATV_SW3), U$2.P$28 (GND), U$2.P$45 (RTN_BATV), U$2.P$46 (RTN_BATV), U$2.P$47 (RTN_BATV), U$2.P$48 (RTN_BATV), U$2.P$53 (RTN_+3V3), U$2.P$54 (RTN_+3V3), U$2.P$55 (RTN_+3V3), U$2.P$56 (RTN_+3V3), U$3.P$3 (RTN_+3V3_SW1), U$3.P$4 (RTN_+3V3_SW1), U$3.P$7 (RTN_+3V3_SW2), U$3.P$8 (RTN_+3V3_SW2), U$3.P$11 (RTN_+3V3_SW3), U$3.P$12 (RTN_+3V3_SW3), U$3.P$15 (RTN_BATV_SW1), U$3.P$16 (RTN_BATV_SW1), U$3.P$19 (RTN_BATV_SW2), U$3.P$20 (RTN_BATV_SW2), U$3.P$23 (RTN_BATV_SW3), U$3.P$24 (RTN_BATV_SW3), U$3.P$28 (GND), U$3.P$45 (RTN_BATV), U$3.P$46 (RTN_BATV), U$3.P$47 (RTN_BATV), U$3.P$48 (RTN_BATV), U$3.P$53 (RTN_+3V3), U$3.P$54 (RTN_+3V3), U$3.P$55 (RTN_+3V3), U$3.P$56 (RTN_+3V3), U$4.P$3 (RTN_+3V3_SW1), U$4.P$4 (RTN_+3V3_SW1), U$4.P$7 (RTN_+3V3_SW2), U$4.P$8 (RTN_+3V3_SW2), U$4.P$11 (RTN_+3V3_SW3), U$4.P$12 (RTN_+3V3_SW3), U$4.P$15 (RTN_BATV_SW1), U$4.P$16 (RTN_BATV_SW1), U$4.P$19 (RTN_BATV_SW2), U$4.P$20 (RTN_BATV_SW2), U$4.P$23 (RTN_BATV_SW3), U$4.P$24 (RTN_BATV_SW3), U$4.P$28 (GND), U$4.P$45 (RTN_BATV), U$4.P$46 (RTN_BATV), U$4.P$47 (RTN_BATV), U$4.P$48 (RTN_BATV), U$4.P$53 (RTN_+3V3), U$4.P$54 (RTN_+3V3), U$4.P$55 (RTN_+3V3), U$4.P$56 (RTN_+3V3), U$5.3, U$5.4
GPIO0: JP1.13, U$1.P$25 (GPIO0), U$2.P$25 (GPIO0), U$3.P$25 (GPIO0), U$4.P$25 (GPIO0)
GPIO1: JP1.15, U$1.P$26 (GPIO1), U$2.P$26 (GPIO1), U$3.P$26 (GPIO1), U$4.P$26 (GPIO1)
GPIO2: JP1.17, U$1.P$34 (/SS/GPIO2), U$2.P$34 (/SS/GPIO2), U$3.P$34 (/SS/GPIO2), U$4.P$34 (/SS/GPIO2)
GPIO3: JP1.19, U$1.P$35 (GPIO3), U$2.P$35 (GPIO3), U$3.P$35 (GPIO3), U$4.P$35 (GPIO3)
GPIO4: JP1.20, U$1.P$36 (GPIO4), U$2.P$36 (GPIO4), U$3.P$36 (GPIO4), U$4.P$36 (GPIO4)
GPIO5: JP1.18, U$1.P$37 (GPIO5), U$2.P$37 (GPIO5), U$3.P$37 (GPIO5), U$4.P$37 (GPIO5)
GPIO6: JP1.16, U$1.P$38 (GPIO6), U$2.P$38 (GPIO6), U$3.P$38 (GPIO6), U$4.P$38 (GPIO6)
GPIO7: JP1.14, U$1.P$39 (GPIO7), U$2.P$39 (GPIO7), U$3.P$39 (GPIO7), U$4.P$39 (GPIO7)
GPIO8: JP1.12, U$1.P$40 (GPIO8), U$2.P$40 (GPIO8), U$3.P$40 (GPIO8), U$4.P$40 (GPIO8)
GPIO9: JP1.10, U$1.P$41 (GPIO9), U$2.P$41 (GPIO9), U$3.P$41 (GPIO9), U$4.P$41 (GPIO9)
GPIO10: JP1.8, U$1.P$42 (GPIO10), U$2.P$42 (GPIO10), U$3.P$42 (GPIO10), U$4.P$42 (GPIO10)
GPIO11: JP1.6, U$1.P$43 (GPIO11), U$2.P$43 (GPIO11), U$3.P$43 (GPIO11), U$4.P$43 (GPIO11)
GPIO12: JP1.4, U$1.P$44 (GPIO12), U$2.P$44 (GPIO12), U$3.P$44 (GPIO12), U$4.P$44 (GPIO12)
MISO: JP1.9, JP3.1, JP4.1, U$1.P$32 (MISO), U$2.P$32 (MISO), U$3.P$32 (MISO), U$4.P$32 (MISO)
MOSI: JP1.7, JP3.4, JP4.4, U$1.P$31 (MOSI), U$2.P$31 (MOSI), U$3.P$31 (MOSI), U$4.P$31 (MOSI)
SCK: JP1.11, JP3.3, JP4.3, U$1.P$33 (SCK), U$2.P$33 (SCK), U$3.P$33 (SCK), U$4.P$33 (SCK)
SCL: JP1.3, U$1.P$29 (SCL), U$2.P$29 (SCL), U$3.P$29 (SCL), U$4.P$29 (SCL)
SDA: JP1.5, U$1.P$30 (SDA), U$2.P$30 (SDA), U$3.P$30 (SDA), U$4.P$30 (SDA)

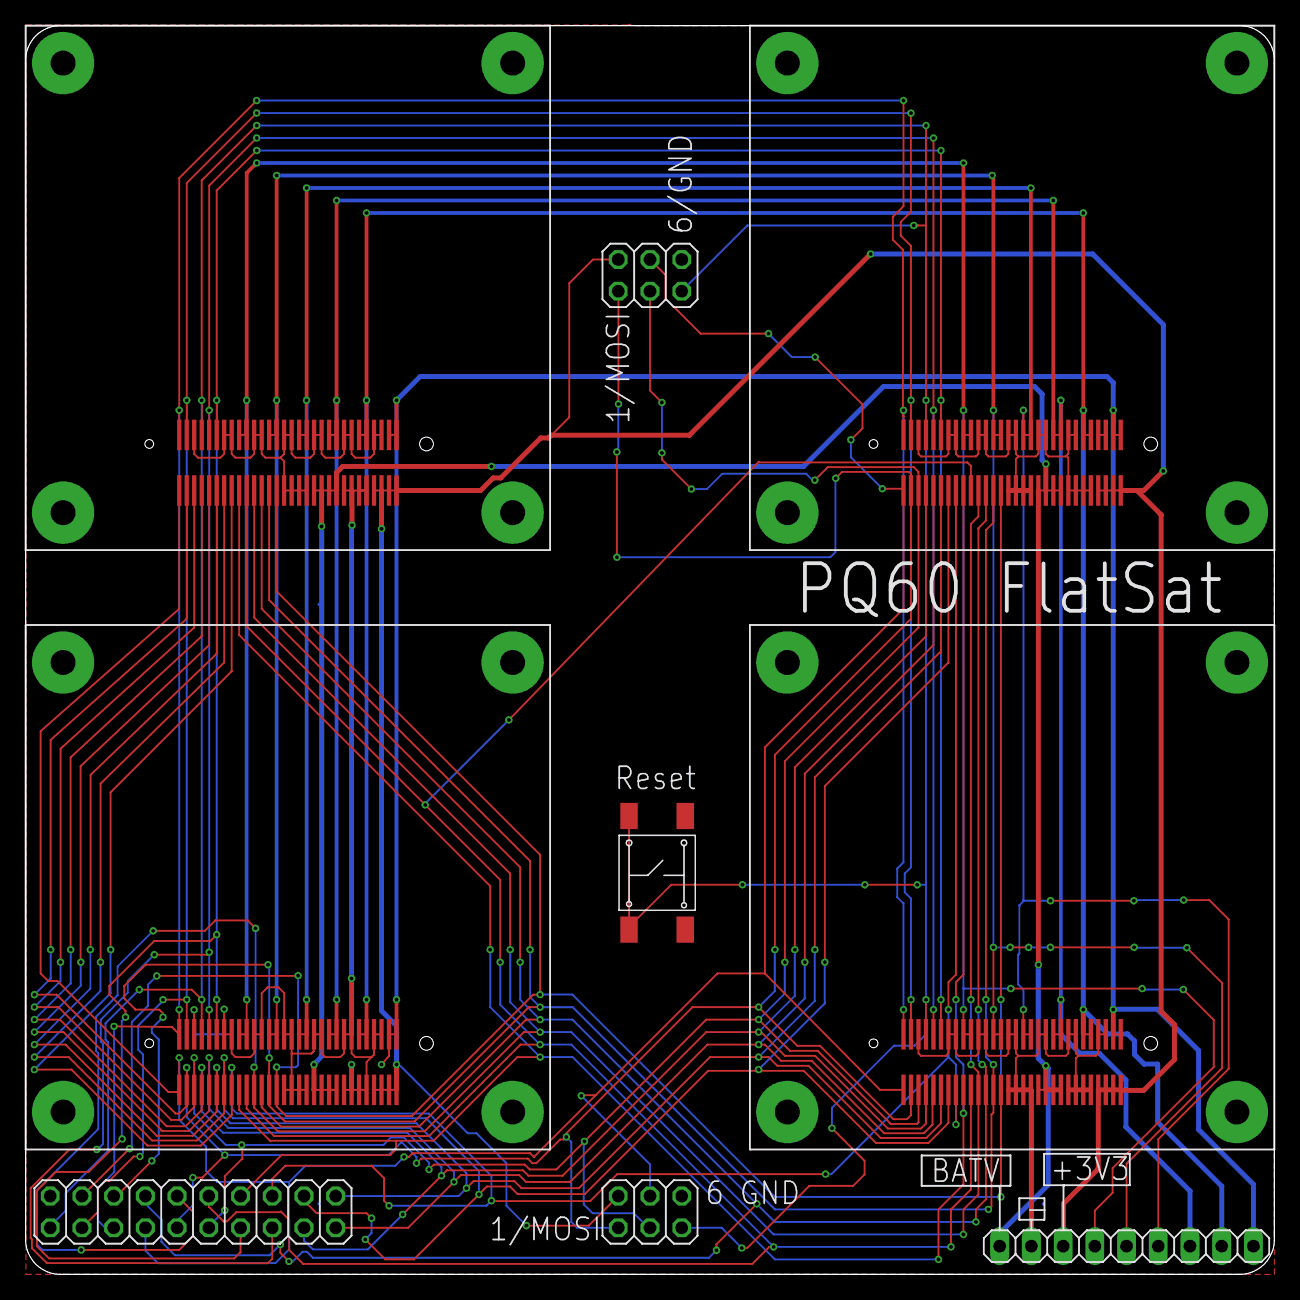
[picture p37: board flatsat.brd from above]

Board: 2 copper layers, 100.0 x 100.0 mm, 9 parts (0 on the bottom side), 28 nets.
