kartikye/MySat/Schematics/EPS/Engineering Model/Test 1.brd

## EAGLE design Schematics/EPS/Engineering Model/Test 1.brd (2015-05-28)

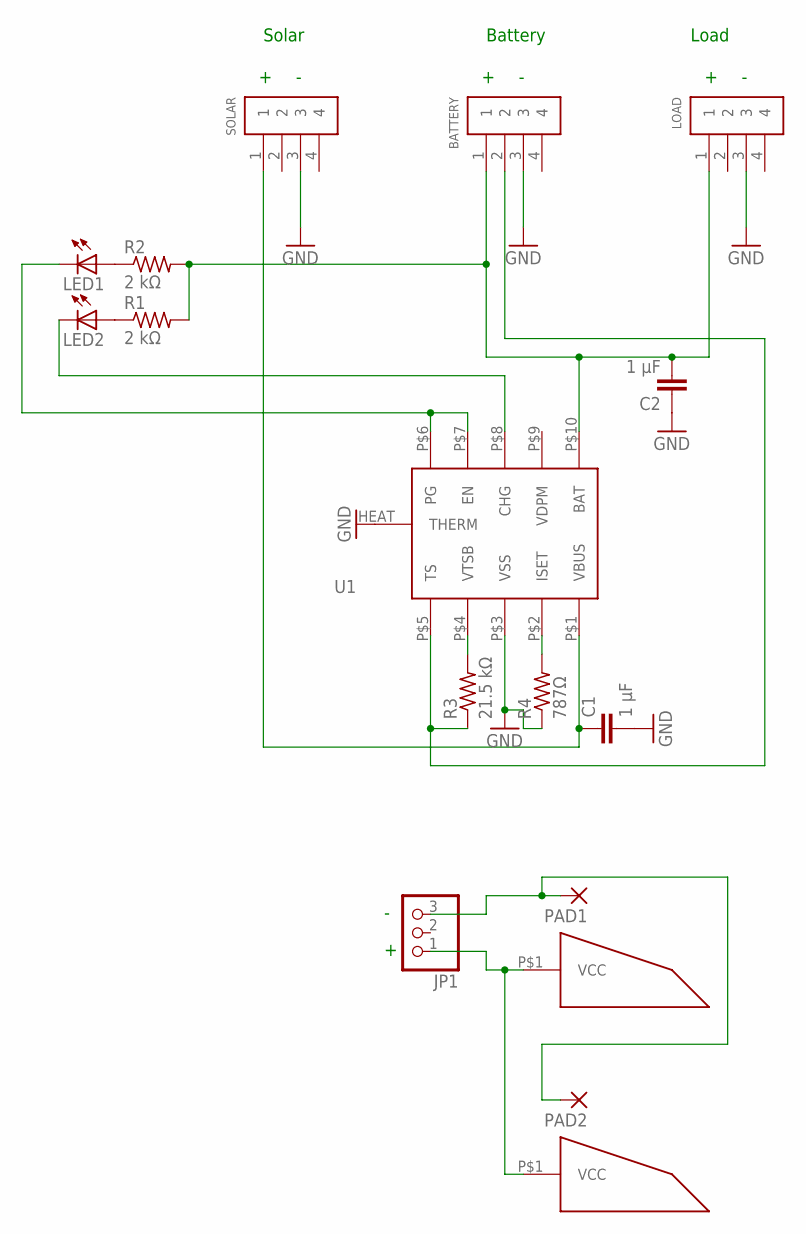
[picture p38: schematic Test 1.sch]

Parts:
BATTERY: 1X4-CLEANBIG; 1X04-CLEANBIG
C1, C2: 1 µF; C0805
JP1: PINHD-1X3; 1X03
LED1, LED2: LEDCHIP-LED0805; CHIP-LED0805
LOAD: 1X4-CLEANBIG; 1X04-CLEANBIG
PAD1, PAD2: SMD2; SMD1,27-2,54
R1, R2: 2 kΩ; R0805
R3: 21.5 kΩ; R0805
R4: 787Ω; R0805
SOLAR: 1X4-CLEANBIG; 1X04-CLEANBIG
U1: BQ24210
U$1, U$2: TRISOLX

Connections:
GND: BATTERY.3, C1.2, C2.1, LOAD.3, R4.1, SOLAR.3, U1.HEAT (THERM), U1.P$3 (VSS)
unnamed: LED1.C, U1.P$6 (PG), U1.P$7 (EN)
unnamed: BATTERY.2, R3.1, U1.P$5 (TS)
unnamed: BATTERY.1, C2.2, LOAD.1, R1.2, R2.2, U1.P$10 (BAT)
unnamed: C1.1, SOLAR.1, U1.P$1 (VBUS)
unnamed: LED1.A, R2.1
unnamed: LED2.A, R1.1
unnamed: R3.2, U1.P$4 (VTSB)
unnamed: R4.2, U1.P$2 (ISET)
unnamed: LED2.C, U1.P$8 (CHG)
unnamed: JP1.3, PAD1.1, PAD2.1
unnamed: JP1.1, U$1.P$1, U$2.P$1

Notes on the sheet:
Battery
Load
Solar

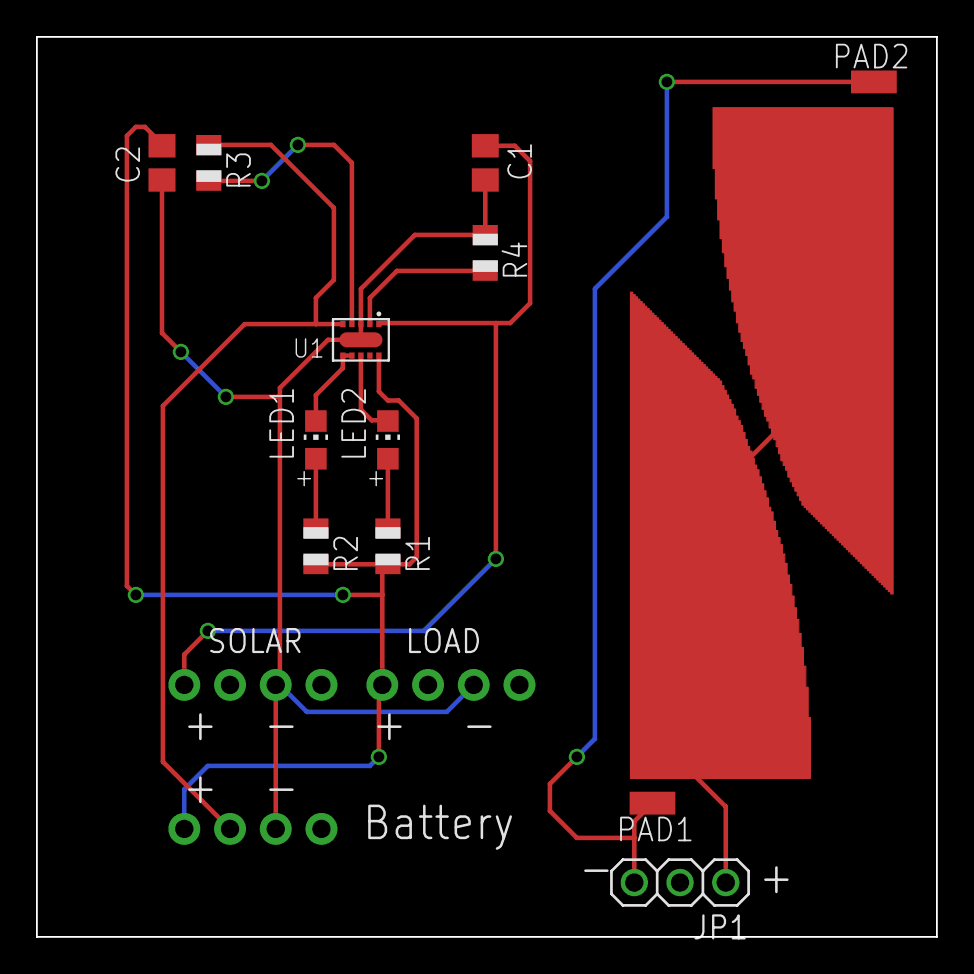
[picture p39: board Test 1.brd from above]

Board: 2 copper layers, 50.0 x 50.0 mm, 17 parts (0 on the bottom side), 12 nets.
