kartikye/MySat/Schematics/EPS/Engineering Model/Electronic Power System EV1.brd

## EAGLE design Schematics/EPS/Engineering Model/Electronic Power System EV1.brd (2015-04-18)

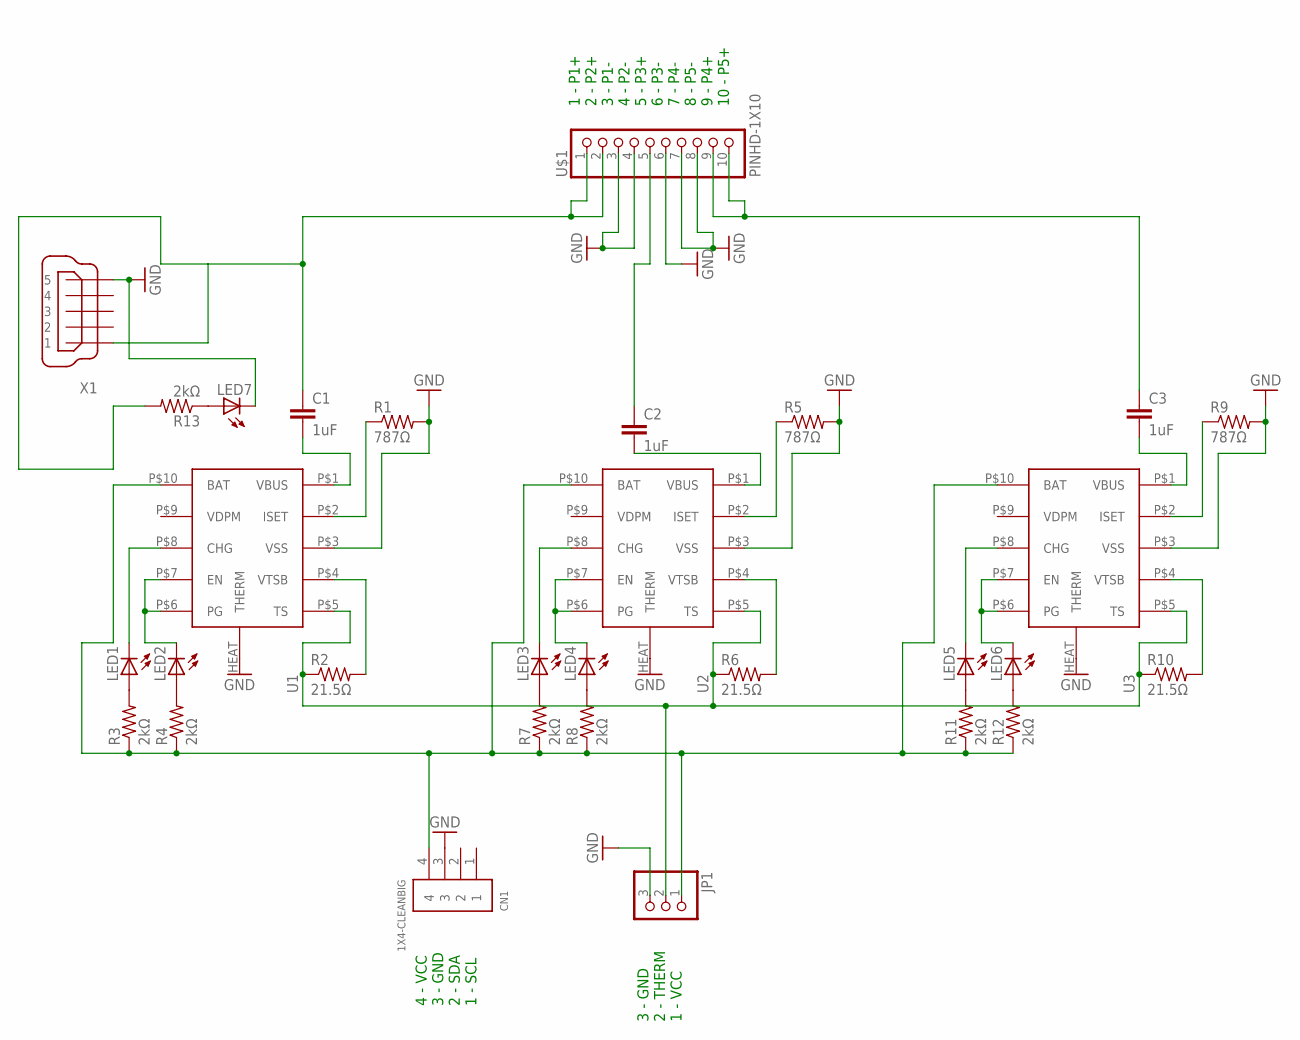
[picture p40: schematic Electronic Power System EV1.sch]

Parts:
C1, C2, C3: 1uF; C0805
CN1: 1X4-CLEANBIG; 1X04-CLEANBIG
JP1: PINHD-1X3; 1X03
LED1, LED2, LED3, LED4, LED5, LED6, LED7: LEDCHIPLED_0805; CHIPLED_0805
R1, R5, R9: 787Ω; R0805
R2, R6, R10: 21.5Ω; R0805
R3, R4, R7, R8, R11, R12, R13: 2kΩ; R0805
U1, U2, U3: BQ24210
U$1: PINHD-1X10; 1X10-BIG
X1: MINI-USB-UX60A-MB-5ST; UX60A-MB-5ST

Connections:
GND: CN1.3, JP1.3, LED7.C, R1.2, R5.2, R9.2, U1.HEAT (THERM), U1.P$3 (VSS), U2.HEAT (THERM), U2.P$3 (VSS), U3.HEAT (THERM), U3.P$3 (VSS), U$1.3, U$1.4, U$1.6, U$1.7, U$1.8, X1.5
unnamed: LED1.C, U1.P$8 (CHG)
unnamed: R10.2, U3.P$4 (VTSB)
unnamed: C1.2, U1.P$1 (VBUS)
unnamed: C2.2, U2.P$1 (VBUS)
unnamed: R6.2, U2.P$4 (VTSB)
unnamed: CN1.4, JP1.1, R3.1, R4.1, R7.1, R8.1, R11.1, R12.1, U1.P$10 (BAT), U2.P$10 (BAT), U3.P$10 (BAT)
unnamed: C3.2, U3.P$1 (VBUS)
unnamed: R2.2, U1.P$4 (VTSB)
unnamed: LED2.C, U1.P$6 (PG), U1.P$7 (EN)
unnamed: LED4.C, U2.P$6 (PG), U2.P$7 (EN)
unnamed: LED6.C, U3.P$6 (PG), U3.P$7 (EN)
unnamed: R5.1, U2.P$2 (ISET)
unnamed: R1.1, U1.P$2 (ISET)
unnamed: R9.1, U3.P$2 (ISET)
unnamed: LED3.C, U2.P$8 (CHG)
unnamed: LED1.A, R3.2
unnamed: LED5.C, U3.P$8 (CHG)
unnamed: C1.1, R13.2, U$1.1, U$1.2, X1.1
unnamed: LED2.A, R4.2
unnamed: LED3.A, R7.2
unnamed: LED4.A, R8.2
unnamed: LED5.A, R11.2
unnamed: LED6.A, R12.2
unnamed: C2.1, U$1.5
unnamed: JP1.2, R2.1, R6.1, R10.1, U1.P$5 (TS), U2.P$5 (TS), U3.P$5 (TS)
unnamed: C3.1, U$1.9, U$1.10
unnamed: LED7.A, R13.1

Notes on the sheet:
1 - P1+ 2 - P2+ 3 - P1- 4 - P2- 5 - P3+ 6 - P3- 7 - P4- 8 - P5- 9 - P4+ 10 - P5+
3 - GND 2 - THERM 1 - VCC
4 - VCC 3 - GND 2 - SDA 1 - SCL

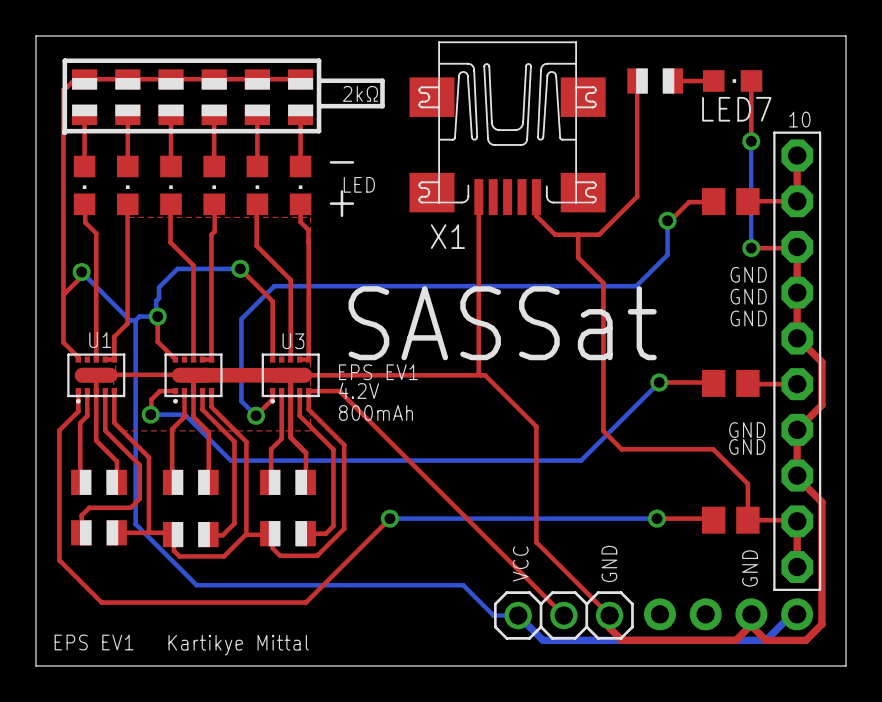
[picture p41: board Electronic Power System EV1.brd from above]

Board: 2 copper layers, 45.0 x 35.0 mm, 30 parts (0 on the bottom side), 28 nets.
