kartikye/MySat/Schematics/Solar Panel/Bottom Panel V5 - New Holes.brd

## EAGLE design Schematics/Solar Panel/Bottom Panel V5 - New Holes.brd (2016-03-22)

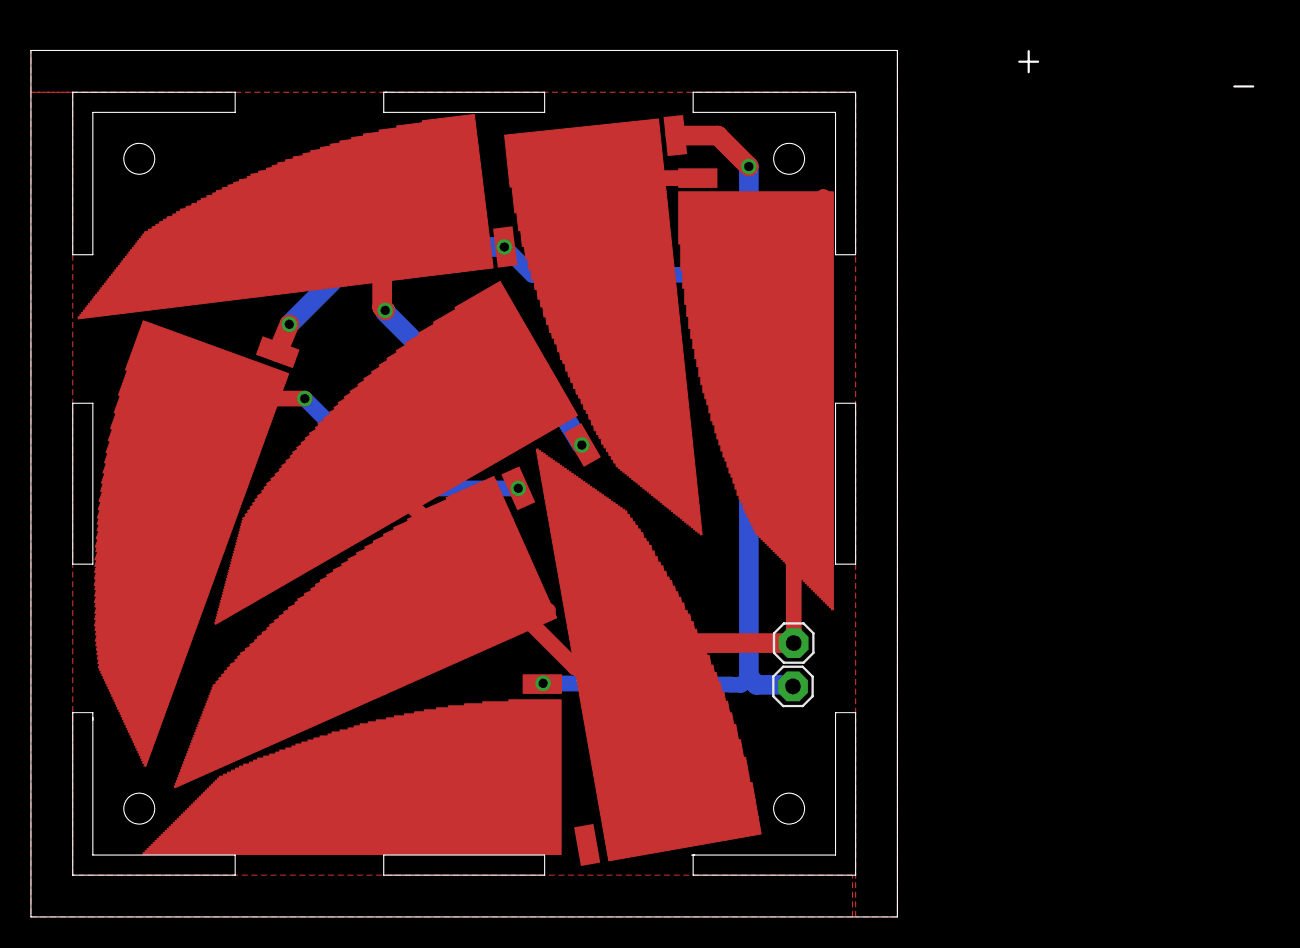
[picture p42: board Bottom Panel V5 - New Holes.brd from above]

Board: 2 copper layers, 56.0 x 56.0 mm, 18 parts (0 on the bottom side), 6 nets.

Parts:
E$1, E$2, E$3, E$4, E$5, E$6, E$7, E$19: TRISOLX
E$8, E$9, E$10, E$11, E$12, E$13, E$14, E$15: SMD1,27-2,54
E$16, E$17: 1X01

Connections:
S$1: E$3.P$1, E$4.P$1, E$5.P$1, E$16.1, E$19.P$1
S$3: E$1.P$1, E$15.1
S$4: E$8.1, E$11.1, E$13.1, E$14.1, E$17.1
S$5: E$2.P$1, E$9.1
S$8: E$7.P$1, E$10.1
S$10: E$6.P$1, E$12.1
