kartikye/MySat/(commit log)

2015-04-18 Revert "New Communication Code"
    This reverts commit 1bc61242c754332bd05d698dd5e2b02570b8d479.
    [Si446x.cpp]
2015-04-18 Revert "Revert "New Communication Code""
    This reverts commit f9d97fe2db5782458990c85c518269c242d87f1a.
    [Si446x.cpp]
2015-04-18 Revert "Revert "Revert "New Communication Code"""
    This reverts commit 57f633d7fe8f4710fa478d5c88a7c094c4a9add2.
    [Si446x.cpp]
2015-04-21 Added RadioHead Library
    [project.cfg]
2015-05-28 Panel
    edde
    [Panel V1.brd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]
2015-06-28 New EPS
    [7193K200.ipt, Antenna.ipt, Base Plate.0001.ipt, Base Plate.ipt, Empty Inner PCB.ipt, Full Side Panel V3.brd, PQ60 EPS FV2.sch, Roller Switch.ipt]
2015-06-28 Added Frame
2015-07-04 Complteded routing
    [-PQ60 EPS FV2.brd, PQ60 EPS FV2.brd, PQ60 EPS FV2.sch]
2015-08-25 many many things
    [-PQ60 EPS FV2.brd, All Panels V4 - Notched 2mm .dxf, All Panels V4 - Notched.dxf, Assembly1.iam, Bottom Panel No Panels.stl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]
2015-12-20 many changes
    [0805_cap_T0.85.ipt, 0805_cap_T0.85.stp, 0805_cap_T1.25.ipt, 0805_cap_T1.25.stp, 1362560816.iam, 1362560944.iam, 1362561584.iam, 1362562096.iam]
